ZSP-Electronics/ZSPR_01_Robot/README.md

# ZSPR_01_Robot
Repo containing all files to create the ZSPR-01 Robot
