ZSP-Electronics/ZSPR_01_Robot/hardware/KiCAD/Internal Battery Monitor/README.md

# Internal Battery Monitor

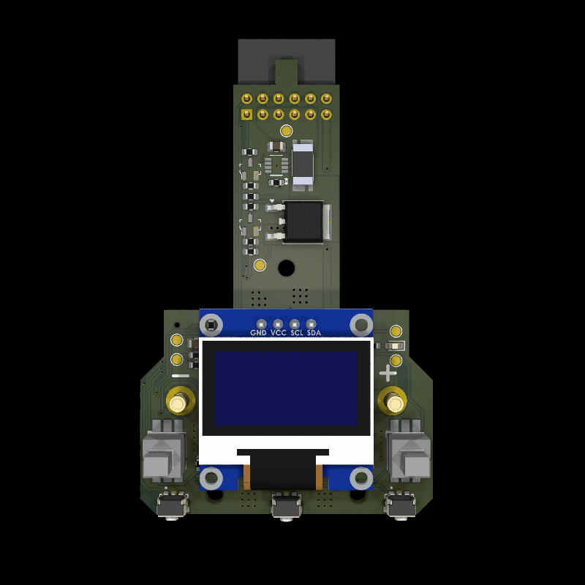
[picture p1: hardware/KiCAD/Internal Battery Monitor/renders/Internal Battery Monitor.gif]
Internal Battery Monitor render
