ZSP-Electronics/ZSPR_01_Robot/hardware/KiCAD/Primary Robot Controller/README.md

# Primary Robot Controller

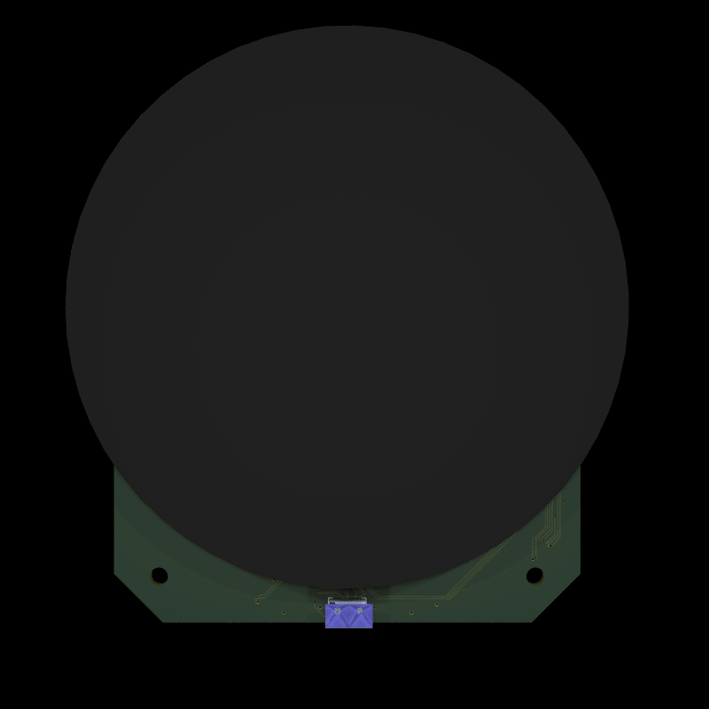
[picture p2: hardware/KiCAD/Primary Robot Controller/renders/Primary Robot Controller.gif]
Primary Robot Controller render
