ZSP-Electronics/ZSPR_01_Robot/hardware/KiCAD/Charge Board/production/bom.csv

Designator | Footprint | Quantity | Value | LCSC Part #
C1, C2 | 0805 | 2 | 10uF
C3 | 0603 | 1 | 100nF
J1 | JST_PH_B2B-PH-K_1x02_P2.00mm_Vertical | 1 | Conn_01x02_Pin
J2 | Magnetic_Pogo_Pins | 1 | Conn_01x04_Socket
J3 | JST_PH_B3B-PH-K_1x03_P2.00mm_Vertical | 1 | Conn_01x03_Pin
Q2 | SOT-363_SC-70-6 | 1 | 2N7002DW-7-F | 2N7002DW-7-F
R10, R8 | 0603 | 2 | 10k
R5, R6, R7, R9 | 0402 | 4 | 10K
U1 | SOT-23 | 1 | AP2127N-2.8
U2 | VL53L0CXV0DH_1 | 1 | VL53L0CXV0DH_1 | VL53L0CXV0DH/1
