ZSP-Electronics/ZSPR_01_Robot/hardware/KiCAD/Primary Robot Controller/production/bom.csv

Designator | Footprint | Quantity | Value | LCSC Part #
BZ1 | MagneticBuzzer_Kobitone_254-EMB84Q-RO | 1 | Buzzer
C1, C17, C2, C3, C36, C4, C70, C71, C74, C75 | 0603 | 10 | 1uF
C10, C11, C14, C19, C20, C23, C24, C34, C5, C6, C7 | 0805 | 11 | 10uF
C12, C15, C16, C18, C25, C26, C27, C35, C37, C45, C47 | 0603 | 11 | 100nF
C13 | CP_EIA-7343-31_Kemet-D | 1 | 100uF
C21, C22, C43, C44 | 0805 | 4 | 22uF
C65 | 0603 | 1 | 4.7uF
C8 | CP_Elec_6.3x5.8 | 1 | 220uF
C9 | CP_Elec_6.3x5.8 | 1 | 100uF
D1, D2 | 0603 | 2 | RED
J1 | IDC-Header_2x06_P2.54mm_Vertical | 1 | Conn_02x06_Odd_Even
J10 | microSD_External_Pin | 1 | microSD
J2 | 2_8in_lcd_40pin05pitch | 1 | Conn_01x40_Pin
J3 | Molex_SPOX_5267-03A_1x03_P2.50mm_Vertical | 1 | Conn_01x03_Socket
J4 | TE_1-84952-5_1x15-1MP_P1.0mm_Horizontal | 1 | Conn_01x15_Socket
J6 | JST_PH_B2B-PH-K_1x02_P2.00mm_Vertical | 1 | Conn_01x02_Socket
J7 | PinSocket_2x04_P2.54mm_Vertical | 1 | Conn_02x04_Counter_Clockwise
L2 | L_Chilisin_BMRF00101040 | 1 | 3.3uH
L3 | L_APV_APH0530 | 1 | 2.2uH
Q1, Q5 | SOT-23 | 2 | DMN10H220L
Q2, Q3 | TO-252-2 | 2 | SUD50P08-25L
Q4 | SOT-23-3 | 1 | MMBT2907A-7-F | MMBT2907A-7-F
R1, R10, R14, R15, R16, R17, R18, R2, R20, R22, R23, R27, R28, R29, R4, R45, R54, R55, R7 | 0603 | 19 | 10K
R11, R5 | R_Shunt_Vishay_WSK2512_6332Metric_T1.19mm | 2 | 5mOhm
R12 | 0603 | 1 | 270K
R13, R46 | 0603 | 2 | 36.5K
R19, R31, R32, R38, R39, R40, R41, R42, R43, R48, R51, R56, R57 | 0603 | 13 | 47K
R21, R8 | 0603 | 2 | 1K
R24, R25, R26, R30, R33, R34, R35, R36, R52, R53 | 0603 | 10 | 4.7K
R3, R9 | 0603 | 2 | 2.2K
R37 | 0603 | 1 | 167K
R44 | 0603 | 1 | 300
R47, R49, R50, R58, R59 | 0603 | 5 | 100K
R6 | 1206 | 1 | 60
R60, R61 | 0603 | 2 | 330
RN1, RN2 | R_Array_Convex_4x0603 | 2 | 10K
TP1, TP2, TP3, TP4, TP5, TP6 | TestPoint_Pad_D1.5mm | 6 | TestPoint
U1, U2 | SOT_32AIDDFR_TEX | 2 | INA232AIDDFR
U10 | CONN_10018784_AMP | 1 | ~
U11 | XDCR_BMI270 | 1 | BMI270
U12 | WLP-4_0.86x0.86mm_P0.4mm | 1 | MMC5603NJ
U13, U8 | QFN50P400X400X80-25N | 2 | KTS1622EUAA-TR
U16 | SOT-23-5 | 1 | AP2112K-1.8
U17 | BMP180 | 1 | BMP180
U18 | IC17_LGA16_STM | 1 | VL53L8CXV0GC/1
U20, U21 | SOT5X3-6_DRL_TEX | 2 | TPS565247DRLR
U3 | SOT-753 | 1 | SN74LVC1G126DBVR | SN74LVC1G125DBVR
U4 | SOT-753 | 1 | SN74LVC1G125DBVR | SN74LVC1G125DBVR
U5, U6 | SOIC_3V204LEX_DIO | 2 | PI4ULS3V204LEX
U7 | SOIC-14_3.9x8.7mm_P1.27mm | 1 | AT42QT1070-S
U9 | ESP32-S3-WROOM-1U | 1 | ESP32-S3-WROOM-1U-N4
