ZSP-Electronics/ZSPR_01_Robot/hardware/KiCAD/Servo Bus Connector/production/bom.csv

Designator | Footprint | Quantity | Value | LCSC Part #
J1, J10, J2, J3, J4, J5, J6, J7, J8, J9 | Molex_SPOX_5268-03A_1x03_P2.50mm_Horizontal | 10 | Conn_01x03_Socket
J11, J12 | Molex_SPOX_5267-03A_1x03_P2.50mm_Vertical | 2 | Conn_01x03_Socket
