ZSP-Electronics/ZSPR_01_Robot/hardware/STL Models/back_assembly.stl

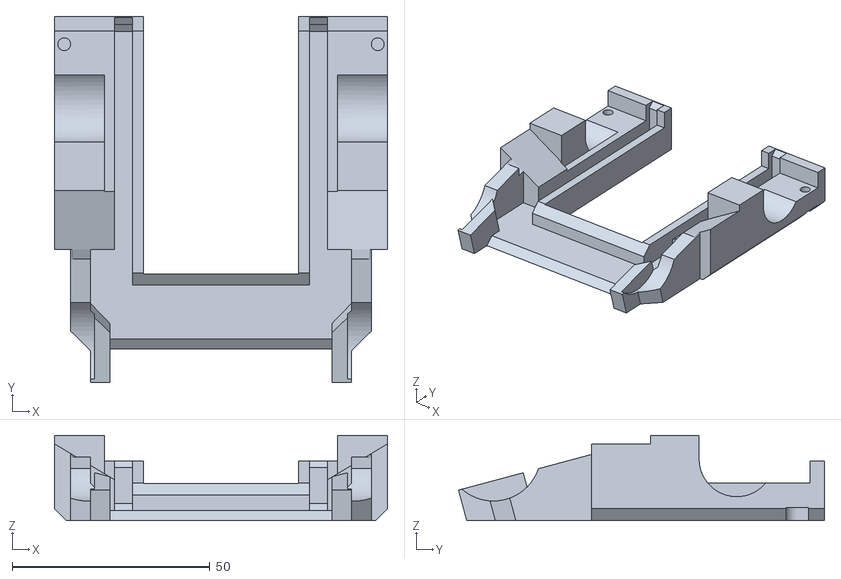
[picture p3: CAD file, 2026-09-27]
hardware/STL Models/back_assembly.stl
84.2 x 92.5 x 21.5
