ZSP-Electronics/ZSPR_01_Robot/hardware/KiCAD/Charge Board/Charge Board.step

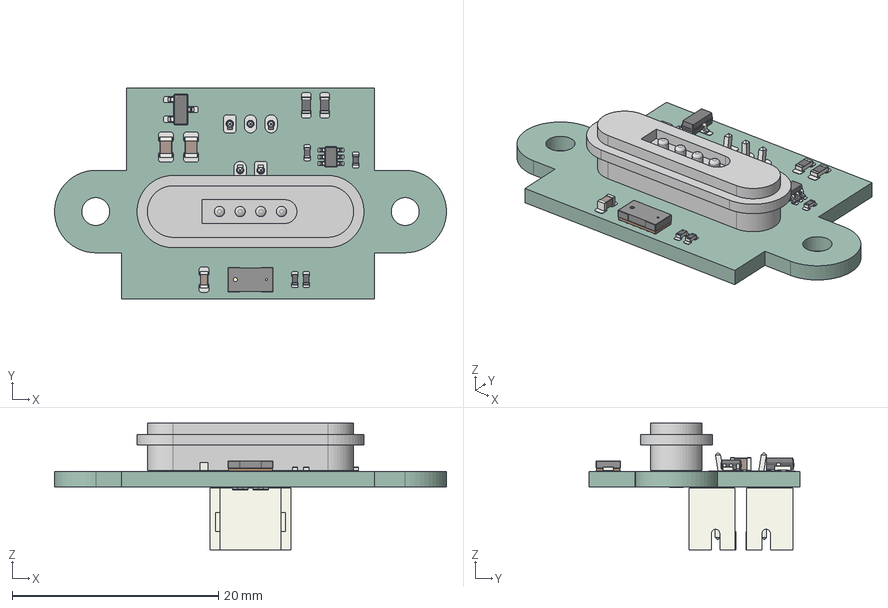
[picture p4: CAD file, 2026-09-27]
hardware/KiCAD/Charge Board/Charge Board.step
38.0 x 20.5 x 12.3 mm
SOT-23
C_0805_2012Metric x 2
R_0402_1005Metric x 4
Magnetic Pogo Male
C_0603_1608Metric
R_0603_1608Metric x 2
SOT-363_SC-70-6
VL53L0CXV0DH_1
JST_PH_B3B-PH-K_1x03_P2.00mm_Vertical
JST_PH_B2B-PH-K_1x02_P2.00mm_Vertical
Charge Board_pad
Charge Board_PCB
