ZSP-Electronics/ZSPR_01_Robot/hardware/KiCAD/Internal Battery Monitor/Internal Battery Monitor.step

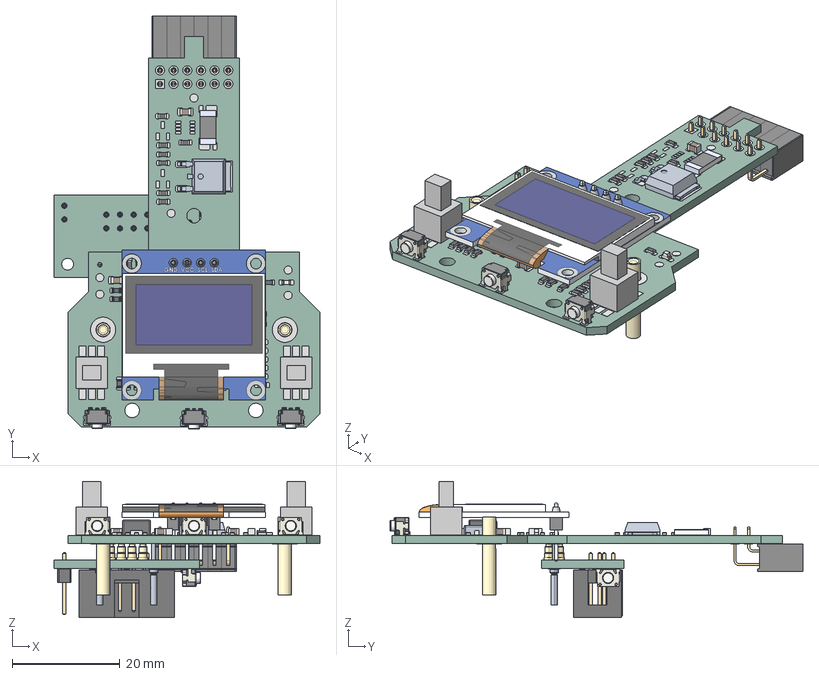
[picture p5: CAD file, 2026-09-27]
hardware/KiCAD/Internal Battery Monitor/Internal Battery Monitor.step
49.4 x 76.8 x 25.4 mm
R_0603_1608Metric x 26
C_0603_1608Metric x 2
C_0805_2012Metric x 13
TL3340AF160QG x 4
Push_Lock_button x 2
LED_0603_1608Metric
CSSU2512FT5L00
OLED-128x64-0.96
Internal Battery MonitorV2 1.28.1
Internal Battery MonitorV2 1.41.1
L_APV_APH0530
PinHeader_1x02_P2.54mm_Vertical
IDC-Header_2x04_P2.54mm_Vertical
c-38941-22l-1-3d x 2
SWD_Programmer_V2_PCB
Pin_PCB-Female x 2
PPPC022LJBN-RC_C06
Pin - Gold x 6
Internal Battery Monitor_pad
Internal Battery Monitor_PCB
