ZSP-Electronics/ZSPR_01_Robot/hardware/KiCAD/Primary Robot Controller/Primary Robot Controller.step

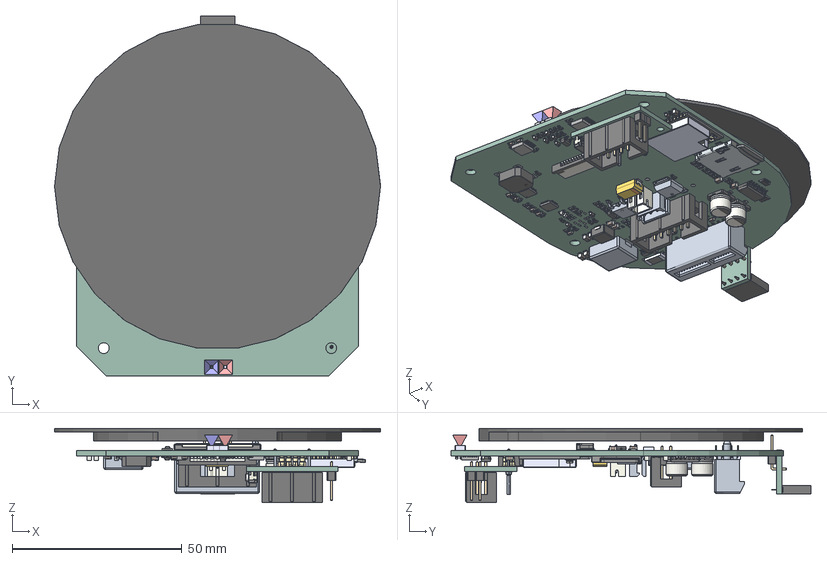
[picture p6: CAD file, 2026-09-27]
hardware/KiCAD/Primary Robot Controller/Primary Robot Controller.step
96.0 x 106.0 x 21.9 mm
R_0603_1608Metric x 58
VL53L8 SUBSTRATE
VL53L8 CAP
VL53L8 Rx Exclusion Cone
VL53L8 Tx Exclusion Cone
C_0603_1608Metric x 22
C_0805_2012Metric x 15
SOT-23 x 2
CSSU2512FT5L00 x 2
R_1206_3216Metric
62684 additional-21 body_40
pin^62684 additional-21 ASS x 40
LCD
BODY-SO x 2
LEAD-SO x 16
PIN1-ID x 2
KTS1622EUAA-TR x 2
R_Array_Convex_4x0603 x 2
ESP32-S3-WROOM-1U-N4
10018784-10200TLF
SOT-23-5
LED_0603_1608Metric x 2
PI4ULS3V204LEX x 2
L_APV_APH0530
Primary Robot Controller 1.66.1
BMI270
Primary Robot Controller 1.75.1 x 2
IDC-Header_2x06_P2.54mm_Vertical
SOIC-14_3.9x8.7mm_P1.27mm
JST_PH_B2B-PH-K_1x02_P2.00mm_Vertical
CP_EIA-7343-31_Kemet-D
MagneticBuzzer_Kobitone_254-EMB84Q-RO
PinHeader_1x02_P2.54mm_Vertical
IDC-Header_2x04_P2.54mm_Vertical
c-38941-22l-1-3d x 2
TL3340AF160QG
SWD_Programmer_V2_PCB
CSD03S010R x 14
microSD_Card
TE_1-84952-5_1x15-1MP_P1.0mm_Horizontal
WLP-4_0.86x0.86mm_P0.4mm
CP_Elec_6.3x5.8 x 2
PinSocket_1x04_P2.54mm_Vertical
PinHeader_1x04_P2.54mm_Horizontal
Capacitive Adapter Board_PCB
Primary Robot Controller_pad
Primary Robot Controller_PCB
