ZSP-Electronics/ZSPR_01_Robot/hardware/KiCAD/Servo Bus Connector/Servo_Bus.step

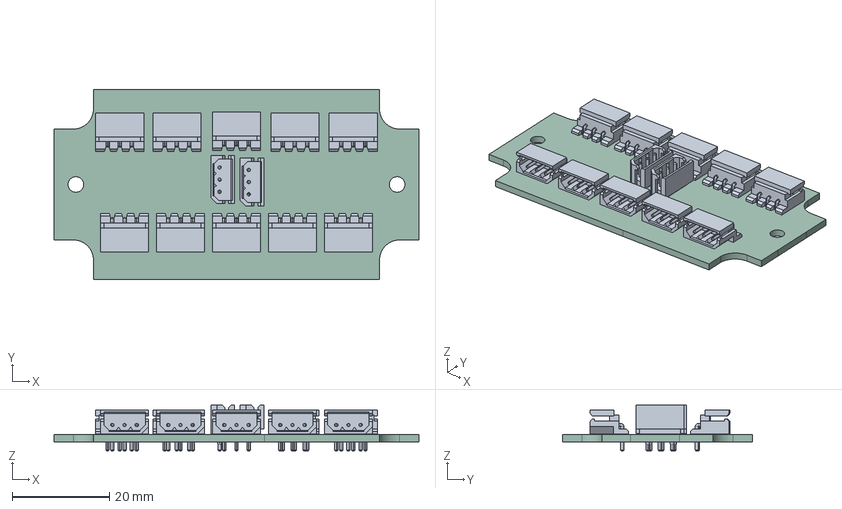
[picture p7: CAD file, 2026-09-27]
hardware/KiCAD/Servo Bus Connector/Servo_Bus.step
75.0 x 39.0 x 9.40 mm
Servo_Bus_PCB
