ZSP-Electronics/ZSPR_01_Robot/hardware/STL Models/arm_house_front1.stl

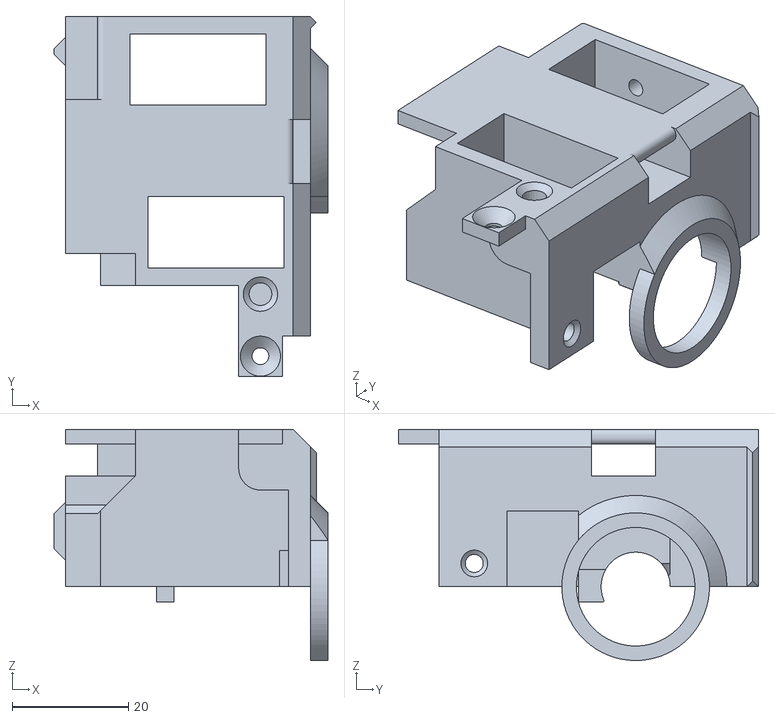
[picture p8: CAD file, 2026-09-27]
hardware/STL Models/arm_house_front1.stl
47.1 x 61.9 x 39.7
