ZSP-Electronics/ZSPR_01_Robot/hardware/STL Models/arm_house_front2.stl

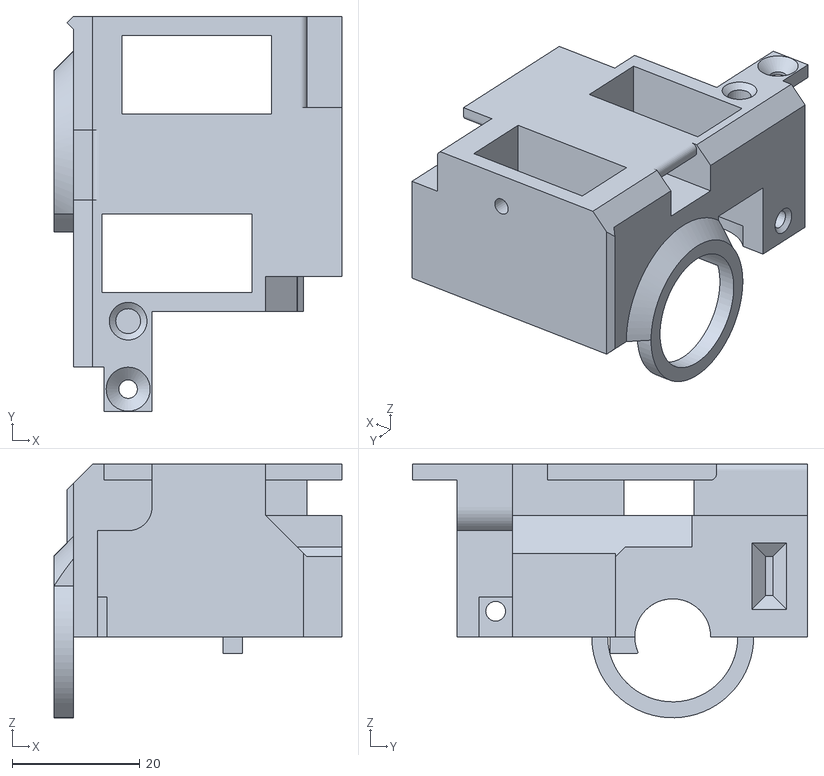
[picture p9: CAD file, 2026-09-27]
hardware/STL Models/arm_house_front2.stl
45.1 x 61.9 x 39.7
