ZSP-Electronics/ZSPR_01_Robot/hardware/STL Models/servo_gear_6x.stl

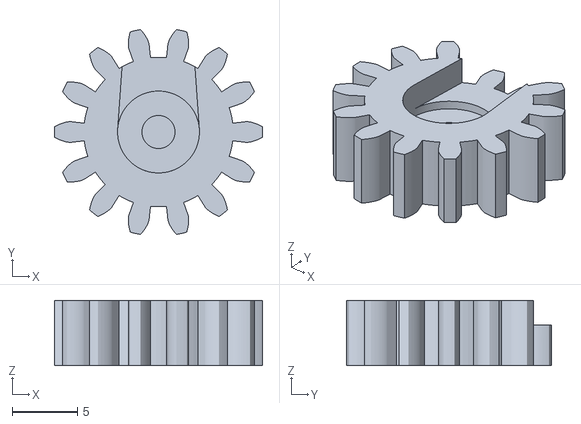
[picture p10: CAD file, 2026-09-27]
hardware/STL Models/servo_gear_6x.stl
16.0 x 15.8 x 5.00
