ZSP-Electronics/ZSPR_01_Robot/hardware/STL Models/arm_arm_body2_mirror.stl

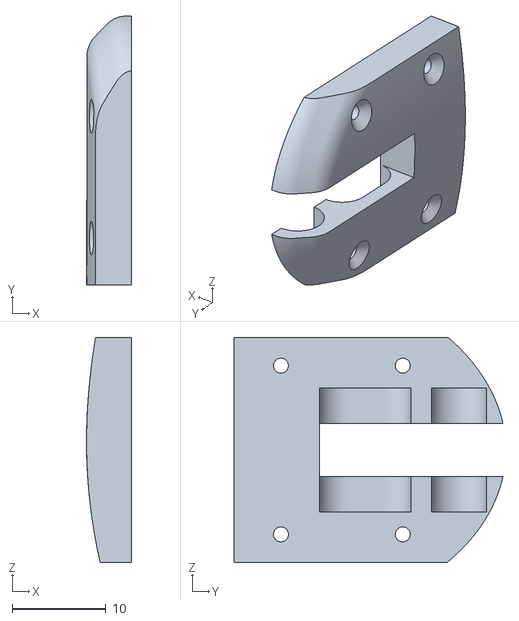
[picture p11: CAD file, 2026-09-27]
hardware/STL Models/arm_arm_body2_mirror.stl
4.80 x 28.7 x 24.0
