ZSP-Electronics/ZSPR_01_Robot/hardware/STL Models/ear_housing1_mirror.stl

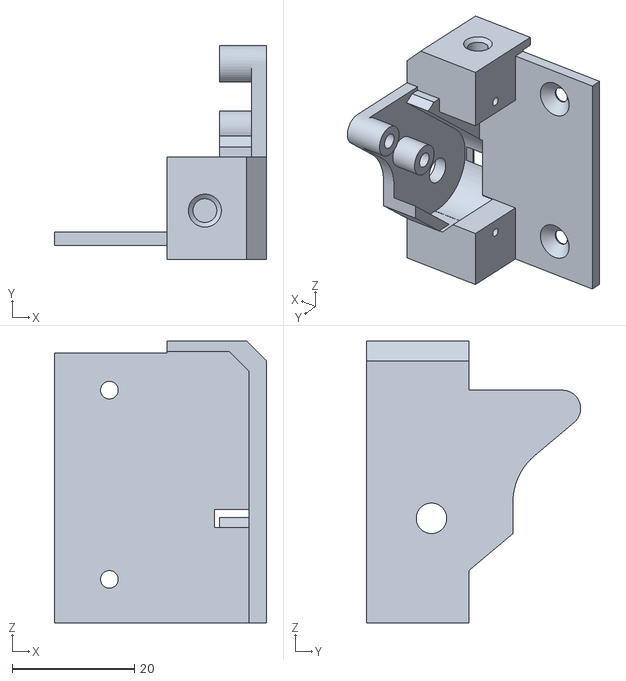
[picture p12: CAD file, 2026-09-27]
hardware/STL Models/ear_housing1_mirror.stl
34.7 x 35.1 x 46.2
