ZSP-Electronics/ZSPR_01_Robot/hardware/STL Models/bottom_riser_2x.stl

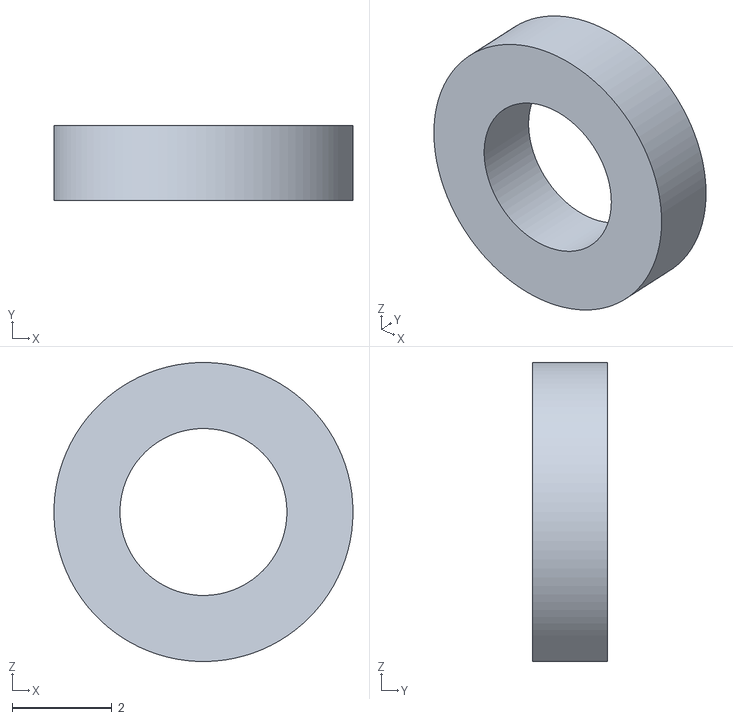
[picture p13: CAD file, 2026-09-27]
hardware/STL Models/bottom_riser_2x.stl
6.00 x 1.50 x 6.00
