ZSP-Electronics/ZSPR_01_Robot/hardware/STL Models/screen_mount.stl

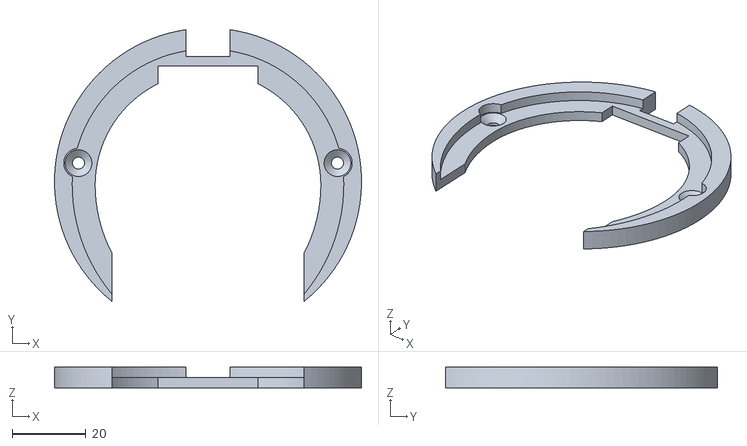
[picture p14: CAD file, 2026-09-27]
hardware/STL Models/screen_mount.stl
83.0 x 73.4 x 5.58
