ZSP-Electronics/ZSPR_01_Robot/hardware/STL Models/arm_servo_gear2_2x.stl

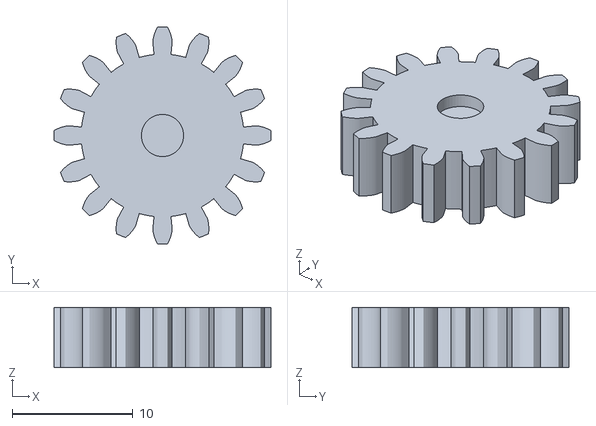
[picture p15: CAD file, 2026-09-27]
hardware/STL Models/arm_servo_gear2_2x.stl
18.0 x 18.0 x 5.00
