ZSP-Electronics/ZSPR_01_Robot/hardware/STL Models/arm_house_back.stl

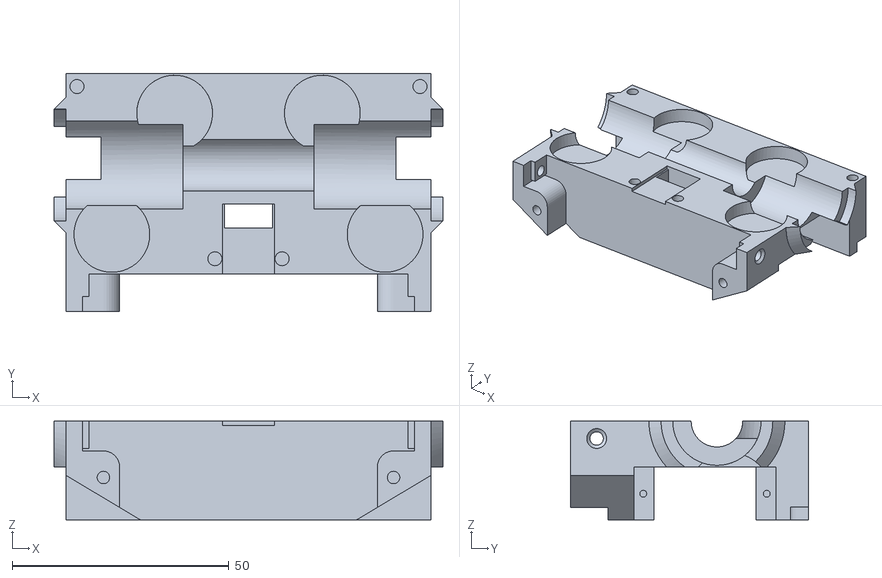
[picture p16: CAD file, 2026-09-27]
hardware/STL Models/arm_house_back.stl
89.8 x 54.9 x 22.8
