ZSP-Electronics/ZSPR_01_Robot/hardware/STL Models/arm_housing_tensioner_mirror.stl

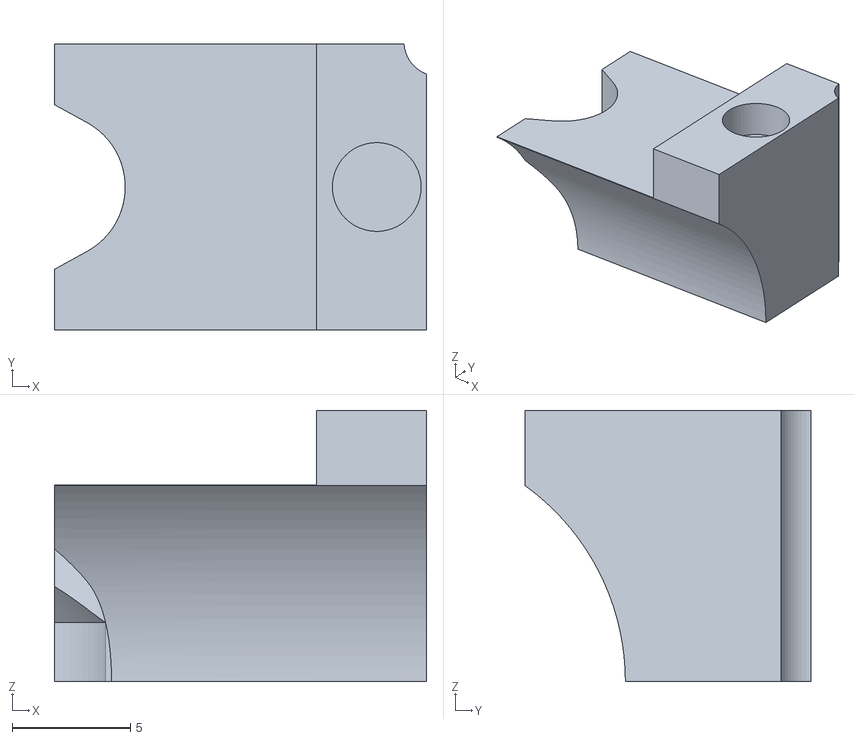
[picture p17: CAD file, 2026-09-27]
hardware/STL Models/arm_housing_tensioner_mirror.stl
15.7 x 12.1 x 11.4
