ZSP-Electronics/ZSPR_01_Robot/hardware/STL Models/arm_arm_body1_mirror.stl

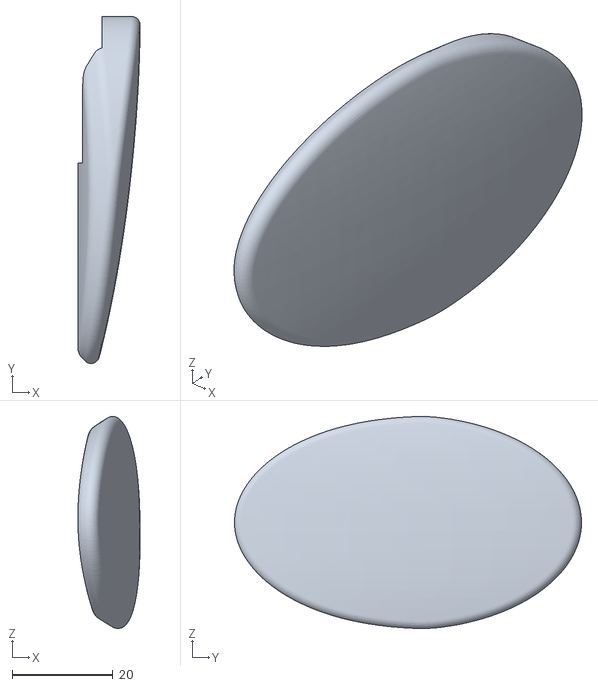
[picture p18: CAD file, 2026-09-27]
hardware/STL Models/arm_arm_body1_mirror.stl
12.4 x 68.9 x 42.1
