ZSP-Electronics/ZSPR_01_Robot/hardware/STL Models/foot_primary_gear.stl

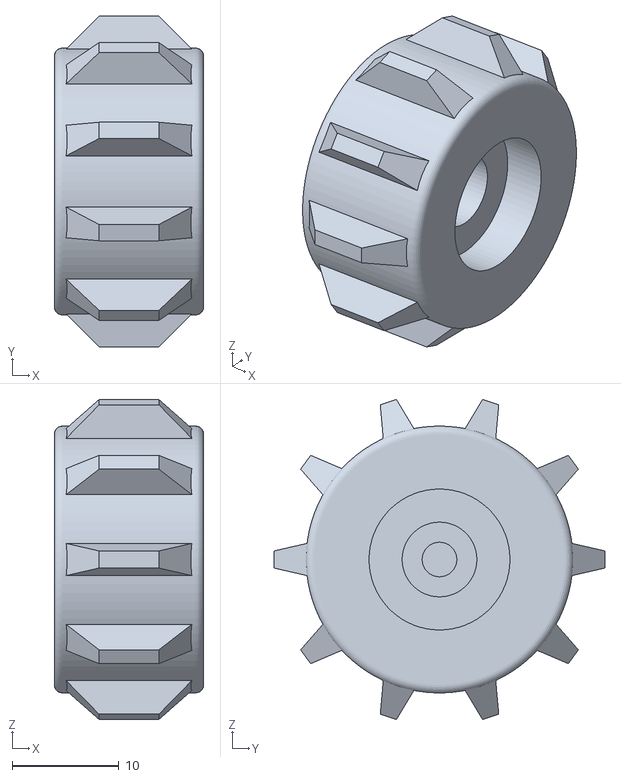
[picture p19: CAD file, 2026-09-27]
hardware/STL Models/foot_primary_gear.stl
14.0 x 31.0 x 30.0
