ZSP-Electronics/ZSPR_01_Robot/hardware/STL Models/ear_gear_2x.stl

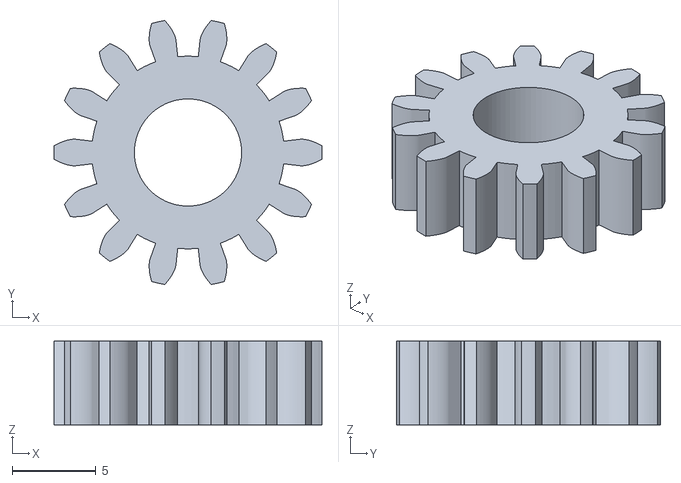
[picture p20: CAD file, 2026-09-27]
hardware/STL Models/ear_gear_2x.stl
16.0 x 15.8 x 5.00
