ZSP-Electronics/ZSPR_01_Robot/hardware/STL Models/bottom_outer_cover.stl

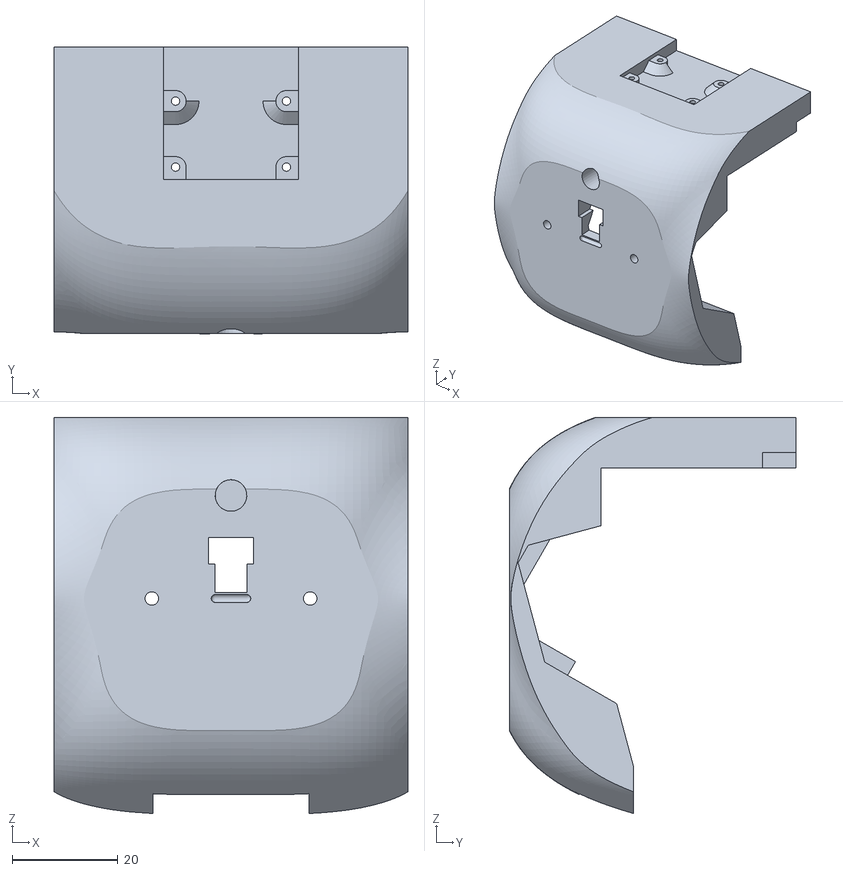
[picture p21: CAD file, 2026-09-27]
hardware/STL Models/bottom_outer_cover.stl
67.0 x 54.3 x 75.0
