ZSP-Electronics/ZSPR_01_Robot/hardware/STL Models/arm_link_rotor_gear_mirror.stl

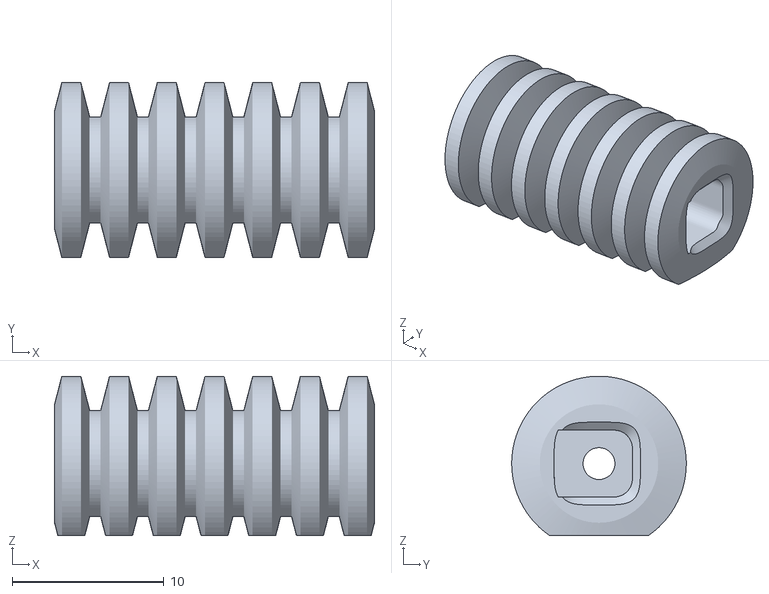
[picture p23: CAD file, 2026-09-27]
hardware/STL Models/arm_link_rotor_gear_mirror.stl
21.1 x 11.5 x 10.5
