ZSP-Electronics/ZSPR_01_Robot/hardware/STL Models/ear_housing2_mirror.stl

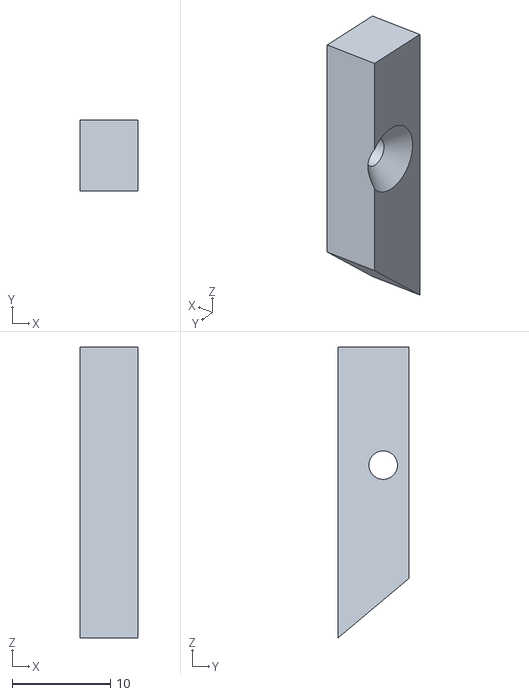
[picture p24: CAD file, 2026-09-27]
hardware/STL Models/ear_housing2_mirror.stl
5.90 x 7.22 x 29.6
