ZSP-Electronics/ZSPR_01_Robot/hardware/STL Models/foot_pivot_gear.stl

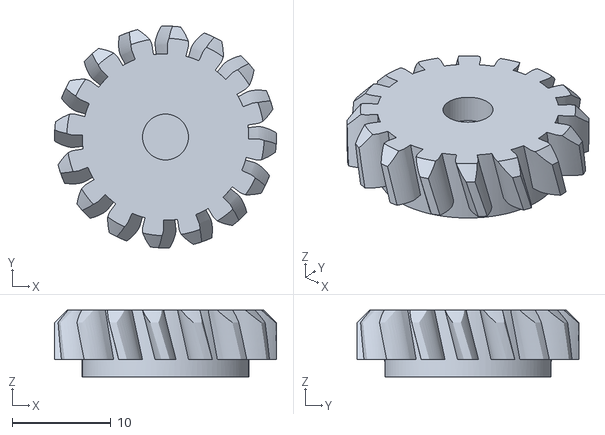
[picture p25: CAD file, 2026-09-27]
hardware/STL Models/foot_pivot_gear.stl
22.5 x 22.5 x 6.75
