ZSP-Electronics/ZSPR_01_Robot/hardware/STL Models/arm_link1_2x.stl

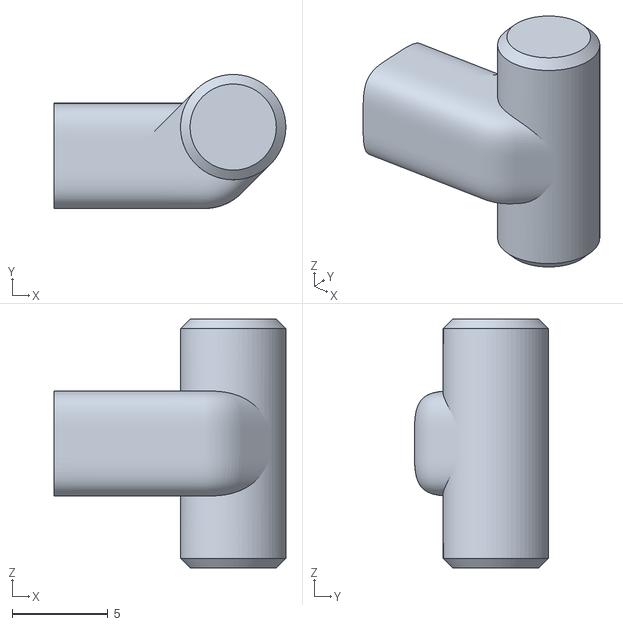
[picture p26: CAD file, 2026-09-27]
hardware/STL Models/arm_link1_2x.stl
12.1 x 7.00 x 13.0
