ZSP-Electronics/ZSPR_01_Robot/hardware/STL Models/arm_link2_2x.stl

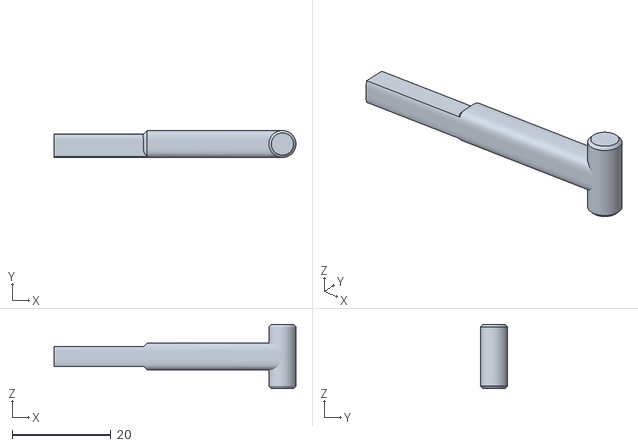
[picture p27: CAD file, 2026-09-27]
hardware/STL Models/arm_link2_2x.stl
49.1 x 5.50 x 13.0
