ZSP-Electronics/ZSPR_01_Robot/hardware/STL Models/bottom_motor_mount.stl

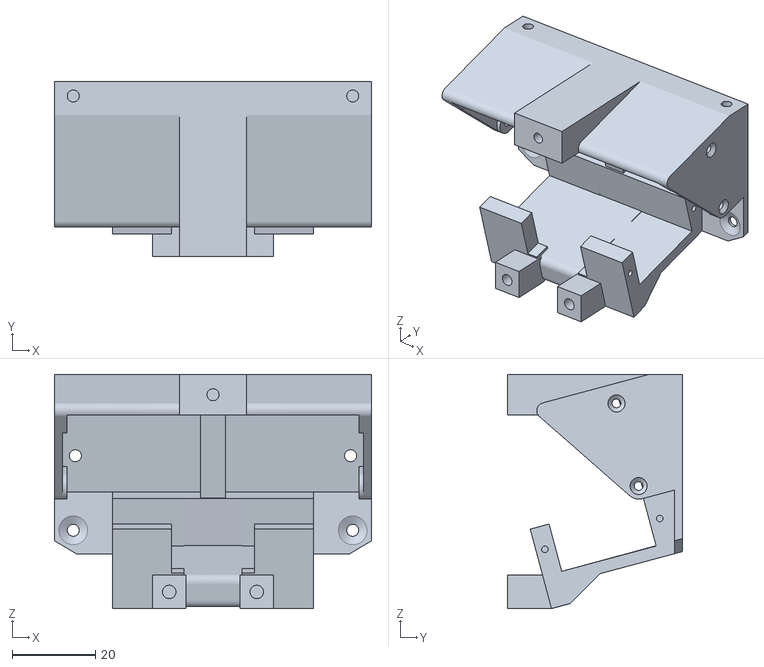
[picture p28: CAD file, 2026-09-27]
hardware/STL Models/bottom_motor_mount.stl
76.0 x 42.0 x 56.2
