ZSP-Electronics/ZSPR_01_Robot/hardware/STL Models/arm_link_gear_mirror.stl

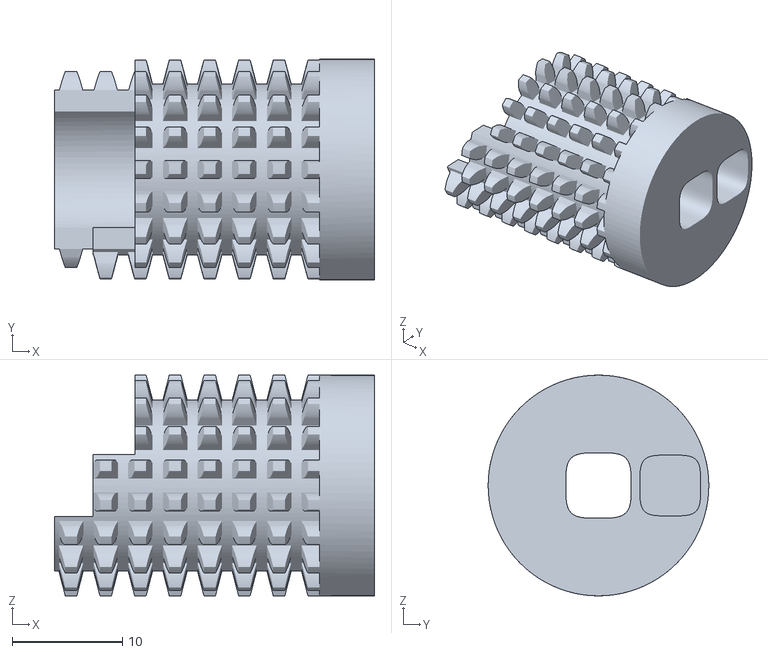
[picture p29: CAD file, 2026-09-27]
hardware/STL Models/arm_link_gear_mirror.stl
29.0 x 20.0 x 20.0
