ZSP-Electronics/ZSPR_01_Robot/hardware/STL Models/foot_panel1_2x.stl

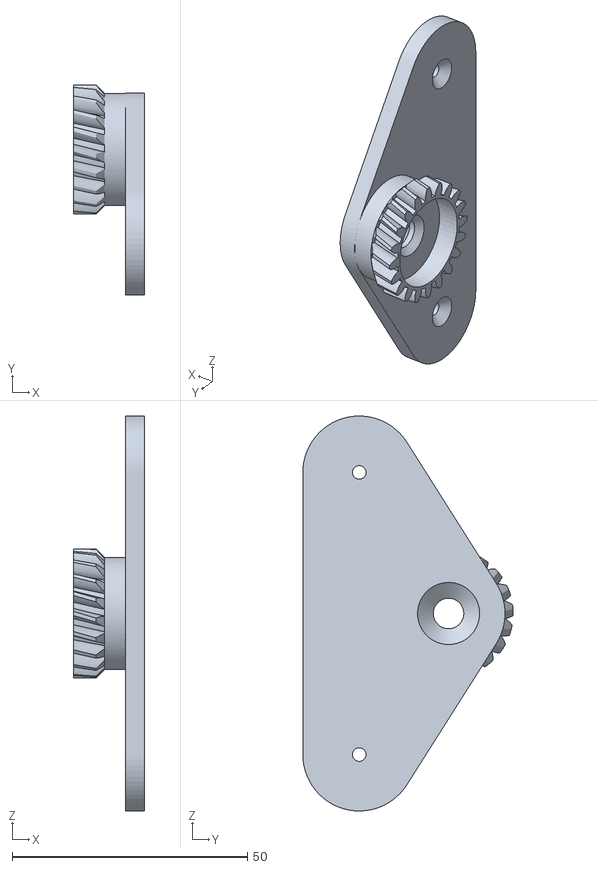
[picture p30: CAD file, 2026-09-27]
hardware/STL Models/foot_panel1_2x.stl
15.1 x 44.7 x 84.0
