ZSP-Electronics/ZSPR_01_Robot/hardware/STL Models/foot_panel2_2x.stl

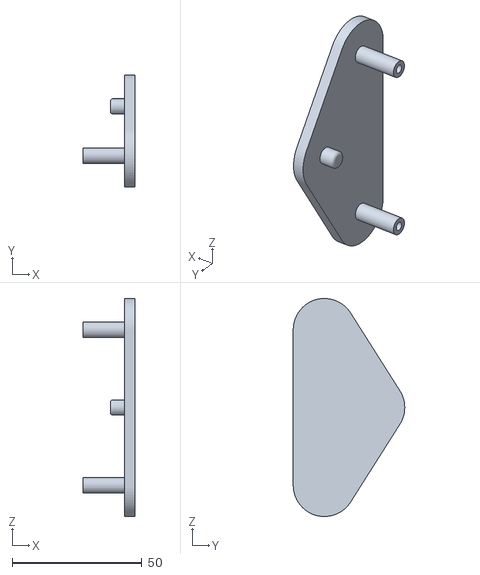
[picture p31: CAD file, 2026-09-27]
hardware/STL Models/foot_panel2_2x.stl
20.0 x 43.0 x 84.0
