ZSP-Electronics/ZSPR_01_Robot/hardware/STL Models/screen_riser2_2x.stl

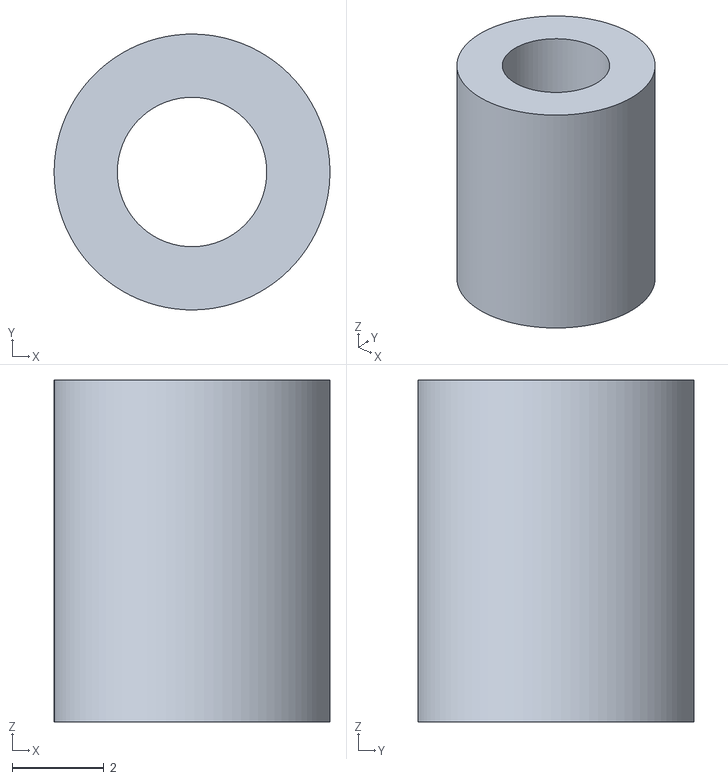
[picture p32: CAD file, 2026-09-27]
hardware/STL Models/screen_riser2_2x.stl
6.00 x 6.00 x 7.44
