ZSP-Electronics/ZSPR_01_Robot/hardware/STL Models/ZSPR_01_Print_Layout.3mf

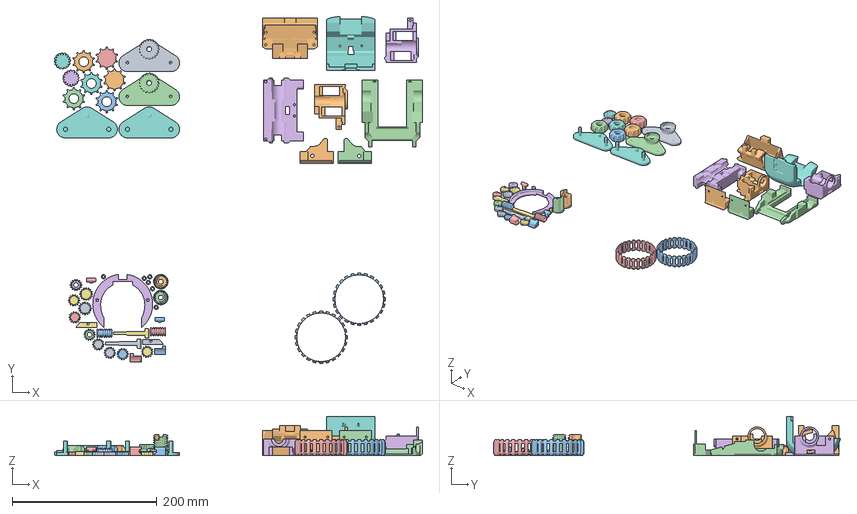
[picture p33: CAD file, 2026-09-27]
hardware/STL Models/ZSPR_01_Print_Layout.3mf
509.8 x 480.2 x 54.3 mm
foot_panel1_2x.stl x 2
arm_link_gear_mirror.stl x 2
track.stl x 2
screen_mount.stl
arm_link2_2x.stl x 2
bottom_outer_cover.stl
bottom_motor_mount.stl
arm_link1_2x.stl x 2
arm_house_front1.stl
arm_servo_gear2_2x.stl x 2
foot_panel2_2x.stl x 2
arm_house_front2.stl
arm_link_rotor_gear_mirror.stl x 2
back_assembly.stl
arm_house_back.stl
ear_housing2_mirror.stl x 2
foot_primary_gear.stl x 2
foot_secondary_gear_2x.stl x 4
ear_gear_2x.stl x 2
servo_gear_6x.stl x 6
foot_pivot_gear.stl x 2
ear_housing1_mirror.stl x 2
arm_housing_tensioner_mirror.stl x 2
screen_riser1_2x.stl x 2
bottom_riser_2x.stl x 2
screen_riser2_2x.stl x 2
