ZSP-Electronics/ZSPR_01_Robot/hardware/STL Models/ear_arm_mirror.stl

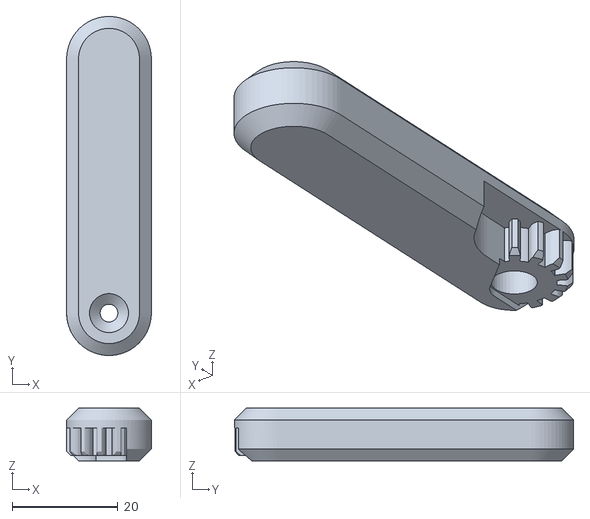
[picture p34: CAD file, 2026-09-27]
hardware/STL Models/ear_arm_mirror.stl
16.0 x 64.0 x 10.0
