ZSP-Electronics/ZSPR_01_Robot/hardware/STL Models/track_2x.stl

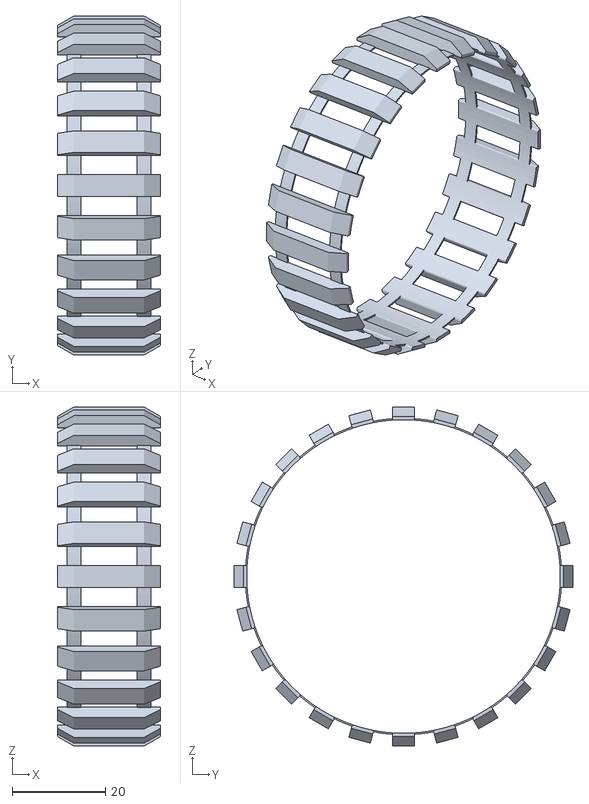
[picture p35: CAD file, 2026-09-27]
hardware/STL Models/track_2x.stl
22.0 x 72.6 x 72.6
