ZSP-Electronics/ZSPR_01_Robot/(list of files, cad)

Other CAD files:
hardware/STL Models/foot_secondary_gear_2x.stl
