ZSP-Electronics/ZSPR_01_Robot/hardware/KiCAD/Primary Robot Controller/Primary Robot Controller Schematic.pdf

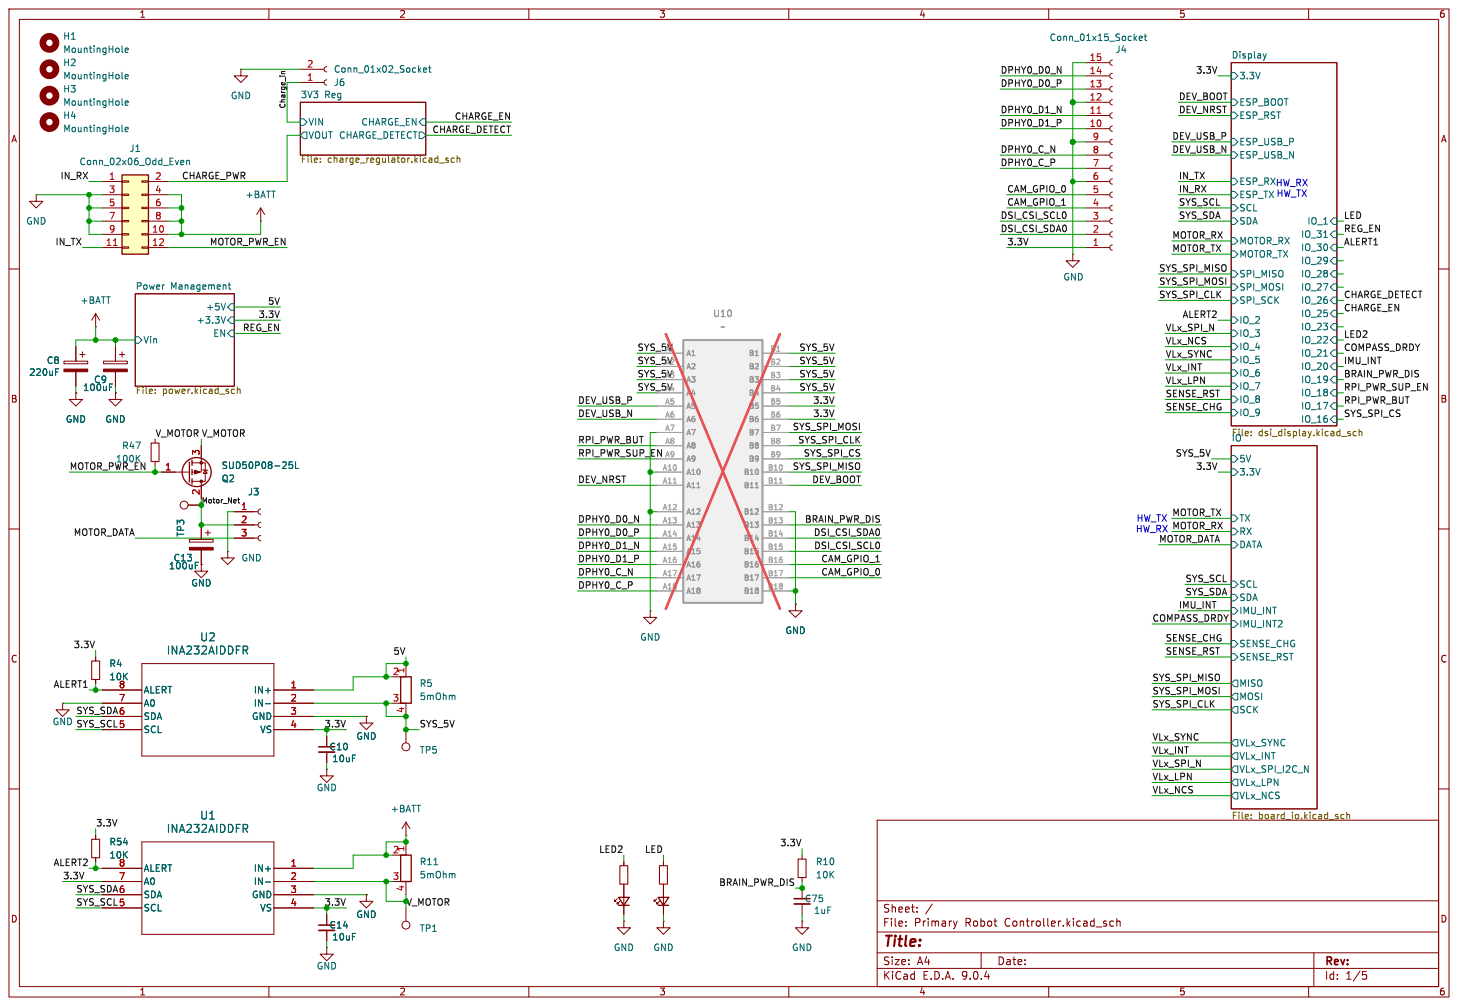
[picture p36: page 1]

H4 MountingHole H2 MountingHole H1 MountingHole H3 MountingHole GND

Power Management File: power.kicad_sch

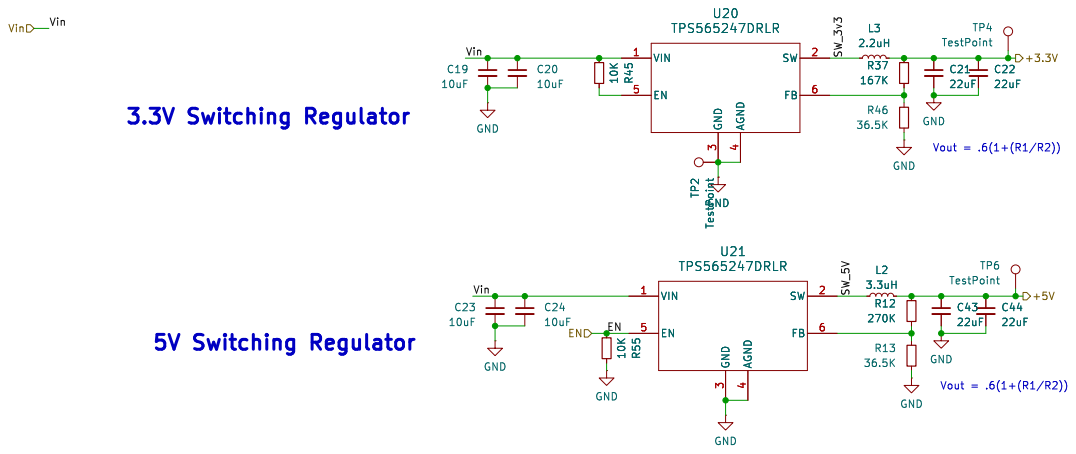
[picture p37: page 2]

4 SW 2 FB 6 10K R45 GND TP2 TestPoint U21 TPS565247DRLR

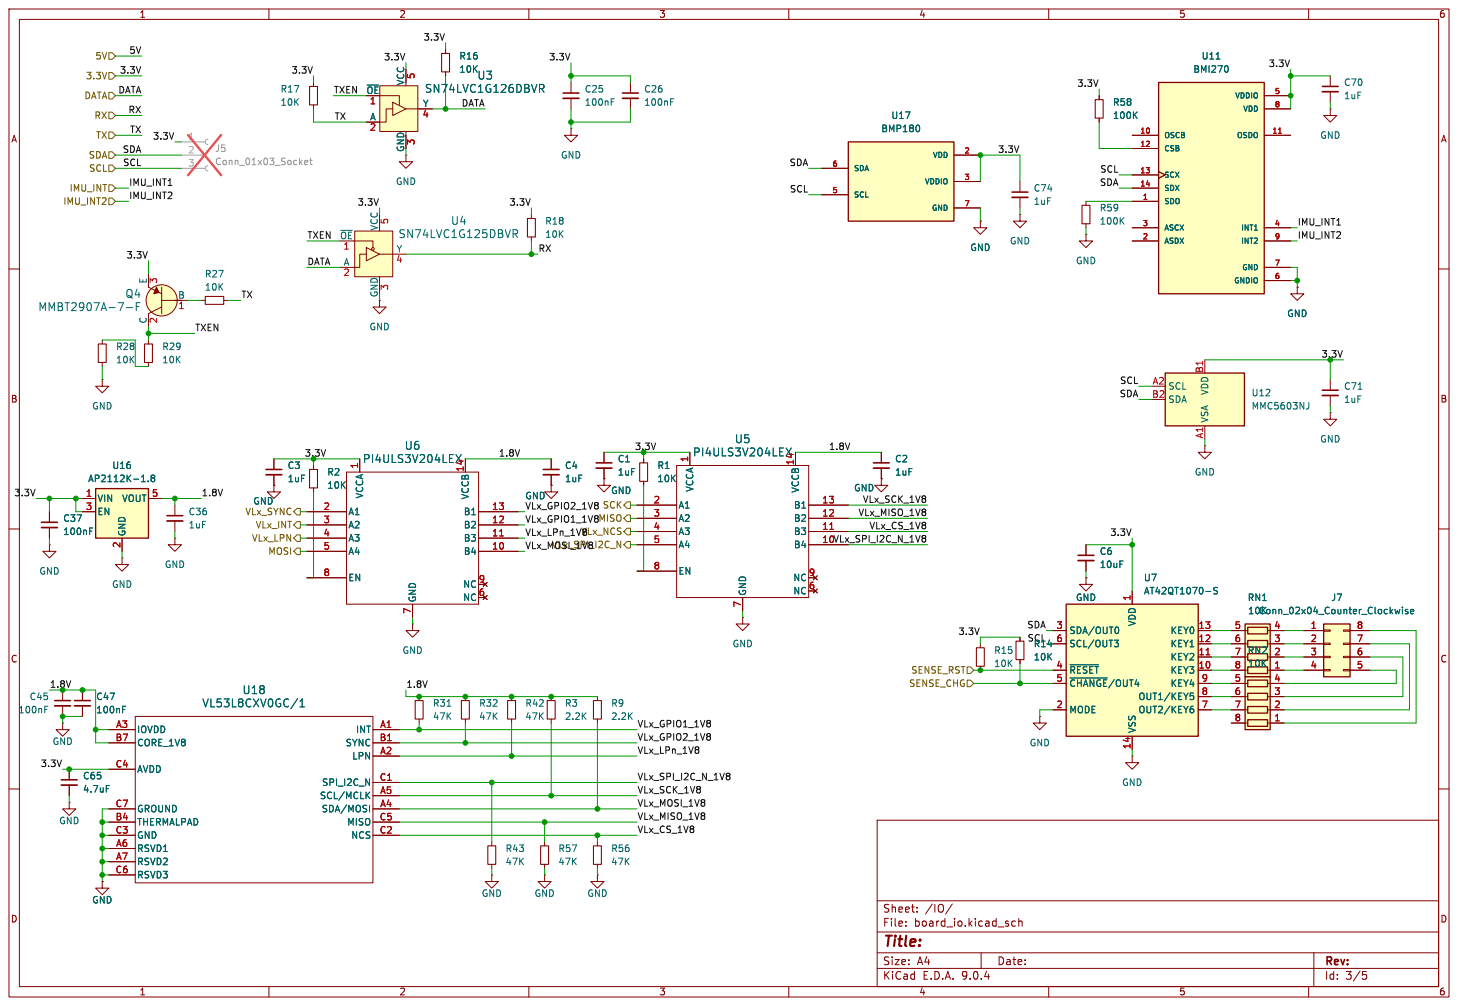
[picture p38: page 3]

7 VCCB 14 NC 9 NC 6 GND

Id: 3/5 Title: File: board_io.kicad_sch Sheet: /IO/

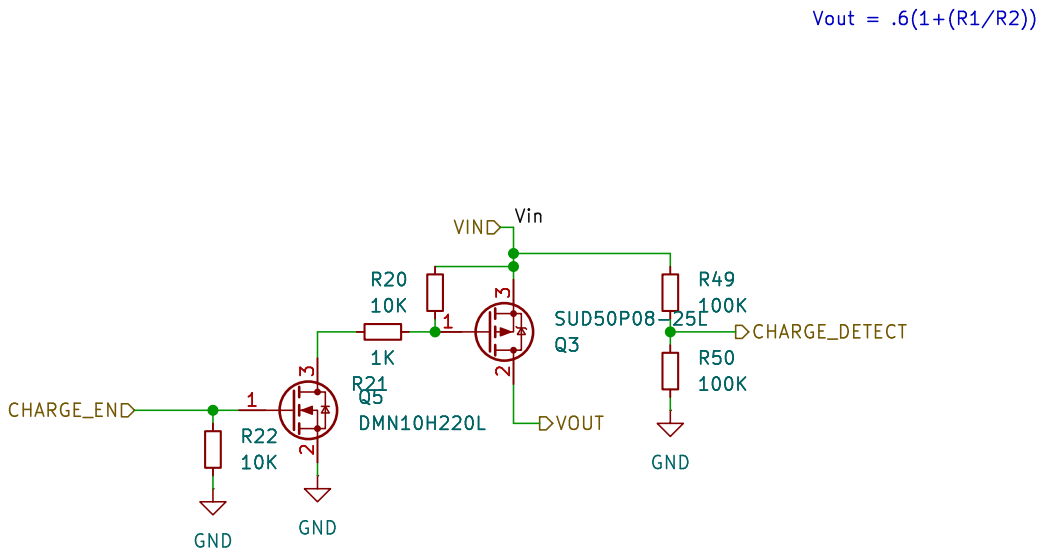
[picture p39: page 4]

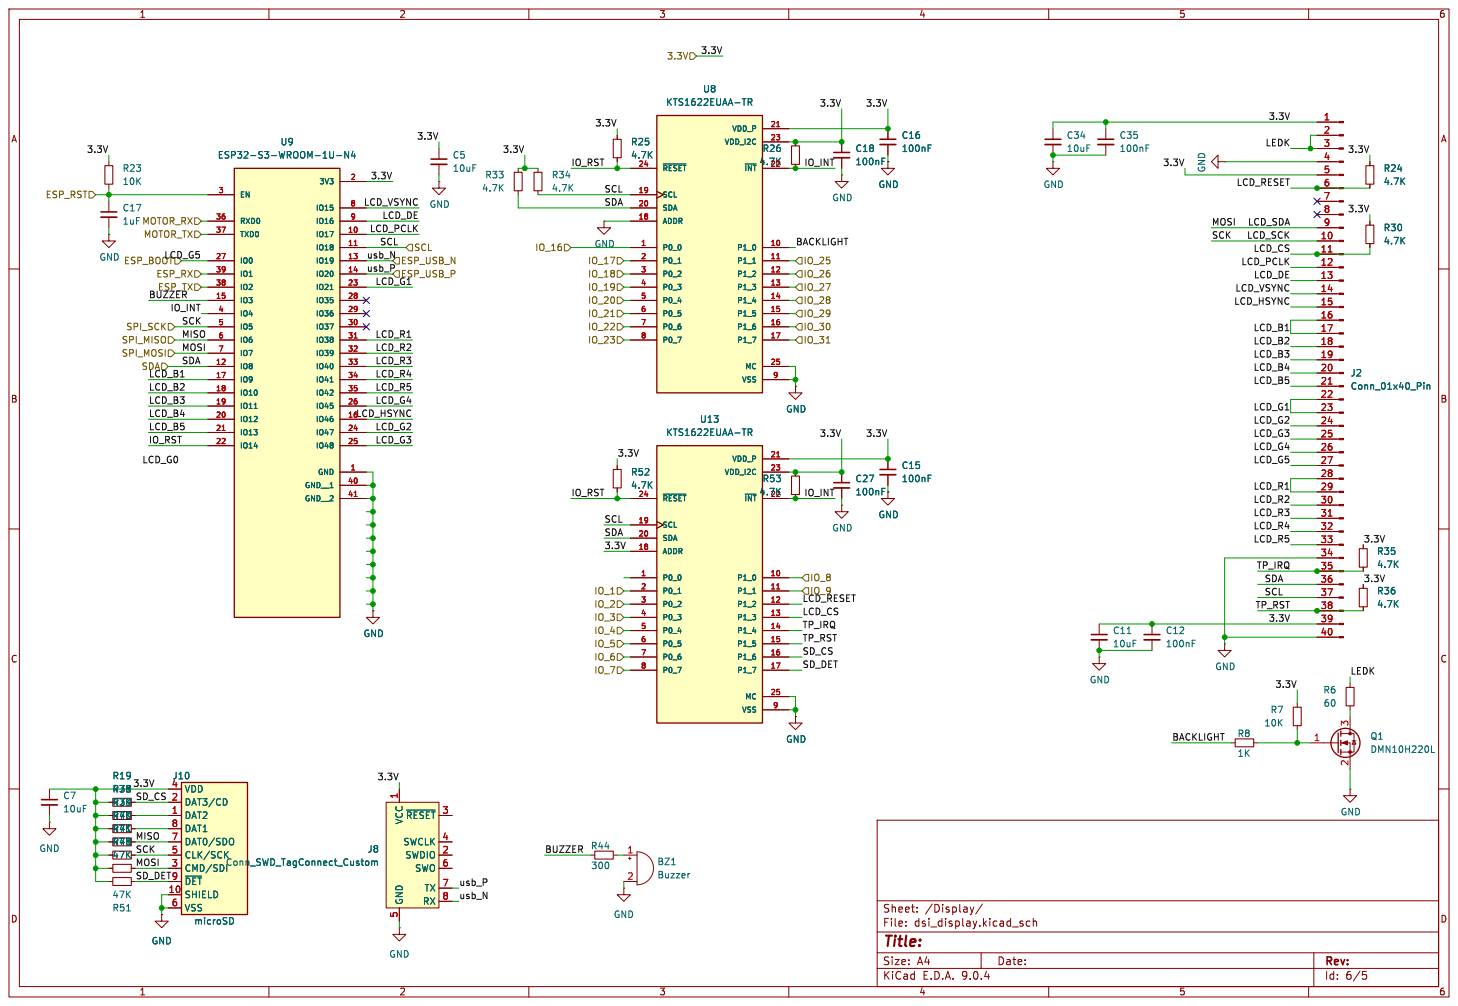
[picture p40: page 5]

5 ~{RESET}3 SWCLK 4 SWDIO 2 SWO 6 TX 7 RX 8

Id: 6/5 Title: File: dsi_display.kicad_sch Sheet: /Display/
