ZSP-Electronics/ZSPR_01_Robot/hardware/KiCAD/Charge Board/Charge Board.pdf

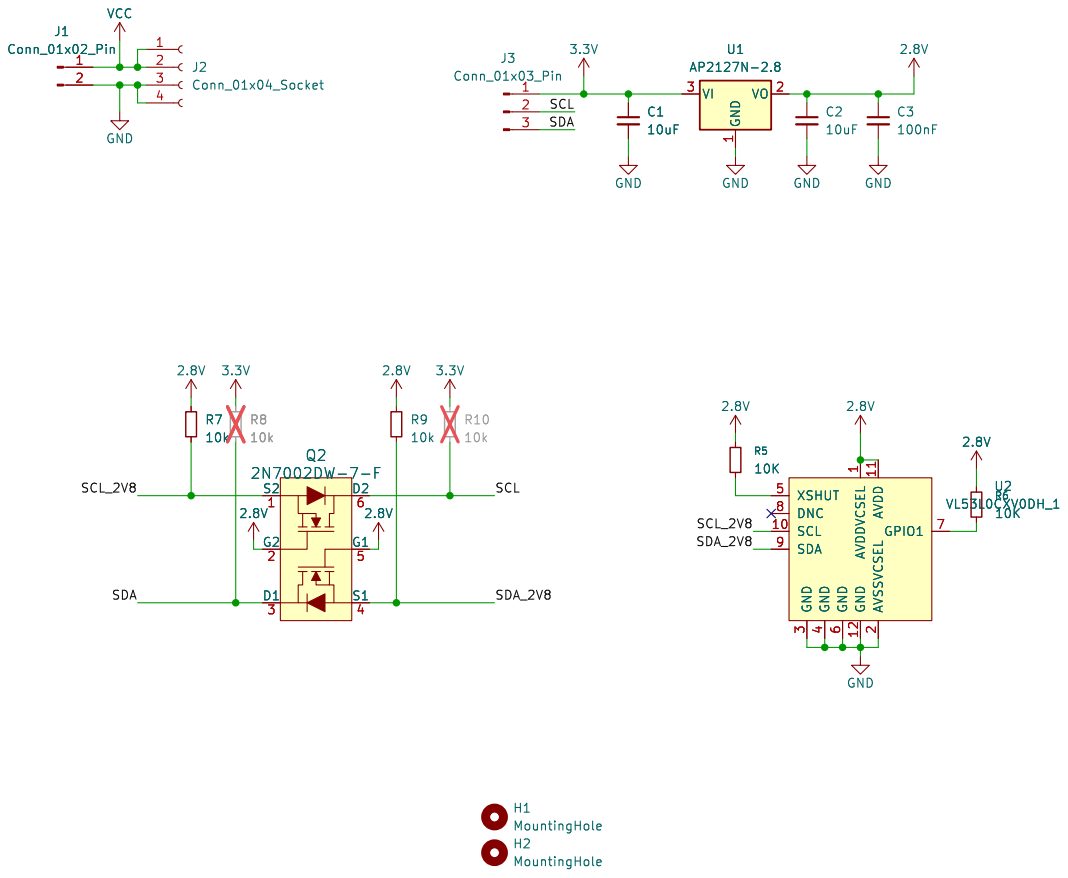
[picture p41: page 1]
