ZSP-Electronics/ZSPR_01_Robot/hardware/KiCAD/Internal Battery Monitor/Internal Battery Monitor Schematic.pdf

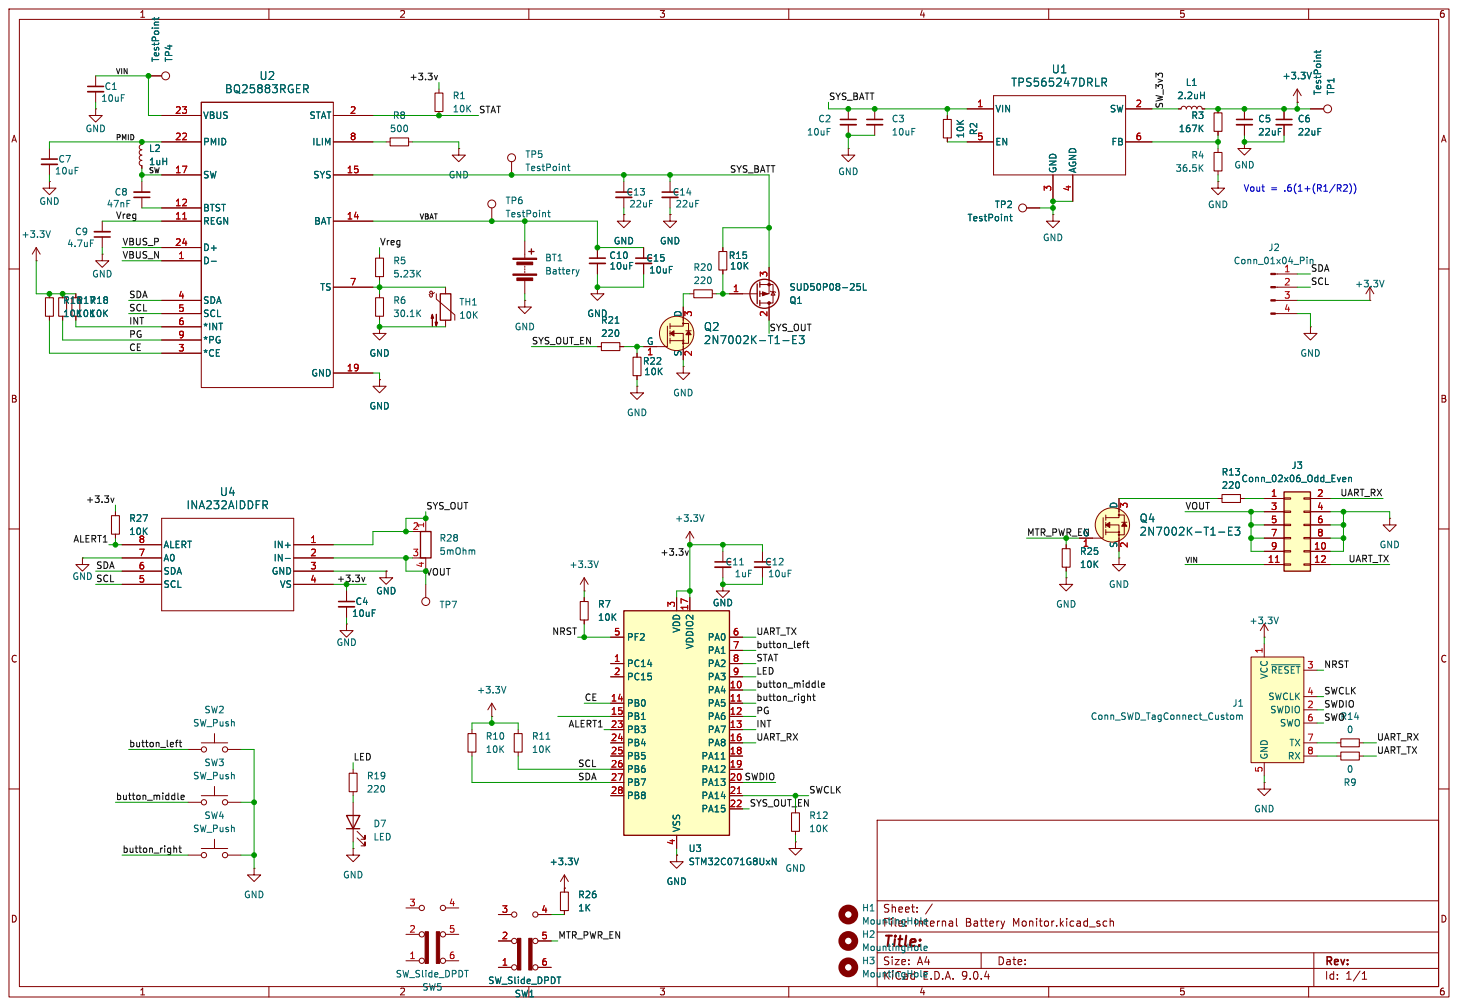
[picture p42: page 1]

5 ~{RESET}3 SWCLK 4 SWDIO 2 SWO 6 TX 7 RX 8
