ZSP-Electronics/ZSPR_01_Robot/firmware/STM32/Battery_Monitor_C071G/Core/Src/main.cpp

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
/* Includes ------------------------------------------------------------------*/
#include "main.h"
#include "dma.h"
#include "i2c.h"
#include "usart.h"
#include "gpio.h"


/* USER CODE BEGIN Includes */
#include "Hardware_config.h"
#include "stm32fxxx.h"
#include "ssd1306.h"
#include <BQ25883.h>
#include "DialogBold10.h"
#include "Battery_Link.h"
/* USER CODE END Includes */

/* USER CODE BEGIN PTD */
// I2C_HandleTypeDef hi2c1;
void update_button_states(void);
void readBatteryStatus(void);
bool estimateSystemLoadCurrent(float* currentAmps);
static void formatFloat2(float value, char* buf, size_t bufSize);
void serviceWatchdog(void);
void checkChargeFaults(void);
void checkInputCurrentFaults(void);
void readStatFields(void);
void drawPrimaryScreen(void);

#ifdef DEBUG
void printFirstFiveRegs(void);
void printAllFields(void);
void printBatteryStatus(void);
#endif
/* USER CODE END PTD */

/* USER CODE BEGIN PD */
// HardwareSerial Serial(&huart1);
BQ25883 charger = BQ25883();
STM32_SSD1306 display;
Battery_Link batteryLink;

/* USER CODE END PD */


/* USER CODE BEGIN PV */
bool battery_int_state = false;
bool left_button_state, middle_button_state, right_button_state = false;
bool previous_left_button_state, previous_middle_button_state, previous_right_button_state = false;
bool battery_pwr_good_state = false;
// uint8_t rxData[UART_BUFFER_SIZE];

//global variables for first five regsiters
float cellVoltageLimit = 0.0;

float chargeCurrentLimit = 0.0;
bool hizMode = true;
bool iLimPin  = false;

float inputVoltageLimit = 0.0;
bool vInDpmRst = false;
bool batDischg = true;
bool pfmOoa = true;

float inputCurrentLimit = 0.0;
bool forceIco = true;
bool forceIndet = true;
bool enIco = false;

float prechargeCurrentLimit = 0.0;
float terminationCurrentLimit = 0.0;

float batteryVoltage = 0.0;
float batteryCurrent = 0.0;
float ext1Voltage = 0.0;
float ext2Voltage = 0.0;
float ext1Current = 0.0;
float ext2Current = 0.0;
uint32_t lastBatteryReadTick = 0;

bool chargeFaultActive = false;
bool inputCurrentIssueActive = false;
bool displayExtPower = true;
/* USER CODE END PV */

/* USER CODE BEGIN PM */
#ifdef __cplusplus
extern "C" {
#endif

// int _write(int file, char *ptr, int len)
// {
//   HAL_UART_Transmit(&huart1, (uint8_t*)ptr, len, HAL_MAX_DELAY);
//   // HAL_UART_Transmit_IT(&huart1, (uint8_t*)ptr, len);
//   return len;
// }

// void HAL_GPIO_EXTI_Callback(uint16_t GPIO_Pin)
// {
// 	if(GPIO_Pin == battery_int_pin)
// 	{
// 		battery_int_state = HAL_GPIO_ReadPin(battery_int);
// 	}
// }

#ifdef __cplusplus
}
#endif
/* USER CODE END PM */



void SystemClock_Config(void);
/* USER CODE BEGIN 0 */

// uint8_T TxData[50];
/* USER CODE END 0 */

/**
  * @brief  The application entry point.
  * @retval int
  */
int main(void)
{

  /* MCU Configuration--------------------------------------------------------*/

  /* Reset of all peripherals, Initializes the Flash interface and the Systick. */
  HAL_Init();

  /* Configure the system clock */
  SystemClock_Config();

  /* USER CODE BEGIN SysInit */
  HAL_Delay(100);
  /* USER CODE END SysInit */

  /* Initialize all configured peripherals */
  MX_GPIO_Init();
  MX_DMA_Init();
  MX_I2C1_Init();
  MX_USART1_UART_Init();
  // /* USER CODE BEGIN 2 */
  Board_GPIO_WritePin(battery_cEnable, LOW);
  Serial.begin(BOARD_USART1);
  #ifdef DEBUG
  Serial.println("Hello World!");
  #endif

  display.SSD1306_begin(BOARD_I2C1, SSD1306_I2C_ADDR);
  display.SSD1306_setFont(&Dialog_bold_10);
  display.SSD1306_setFontSize(1);

  if(charger.begin(BOARD_I2C1)){
    #ifdef DEBUG
    Serial.println(F("BQ25883 is working..."));
    #endif
    charger.setADC_EN(true);        //enable ADC
    charger.setADC_ONE_SHOT(false); //continuous conversion mode so VBAT/ICHG stay up to date
    // ILIM is grounded directly (no resistor) on this board, which the IC reads as the
    // minimum input current tier; since the effective limit is min(ILIM pin, IINDPM
    // register), that floor silently overrides IINDPM. Disable the pin function so the
    // register is authoritative - see setInputCurrentLimit() for the actual limit.
    charger.setEN_CHG(true);
    charger.setHIZMode(false);          //HIZ already defaults off at power-on-reset, set explicitly so the input path isn't left implicit
    charger.setILIMPinFunction(false);
    charger.setInputCurrentLimit(0.5);  //set IINDPM to 0.5A, which is the actual limit on this board
    // ICHG otherwise sits at its 1.5A power-on default (never set elsewhere), which is
    // higher than IINDPM and therefore misleading to read back - align it to the same
    // 500mA ceiling so getChargeCurrentLimit() reflects what can actually flow.
    charger.setChargeCurrentLimit(0.5);
    // charger.setADC_SAMPLE_SPEED(0b00); //fastest conversion speed
    // charger.readChargeCurrentLimitReg(); //cache ICHG so getChargeCurrentLimit()
    charger.readCellVoltageLimitReg(); //cache VREG so getCellVoltageLimit() reflects the actual charger setting, not a zeroed default
  }
  else{
    // If BQ25883 is not working, blink the LED to indicate an error
    #ifdef DEBUG
    Serial.println(F("BQ25883 is NOT working.  Check your wires..."));
    #endif
    while(1){
      Board_GPIO_TogglePin(user_led);
      HAL_Delay(500);
    }
  }

  drawPrimaryScreen();

  // getFirstFiveRegs();
  // printFirstFiveRegs();

  // printAllFields();

  
  
  /* USER CODE END 2 */
  
  /* Infinite loop */
  /* USER CODE BEGIN WHILE */
  while (1)
  {

    // Service the Primary Controller link: answer REQUEST_VOLTAGE frames and
    // latch any SEND_CURRENT_POWER rail data pushed from the Primary.
    batteryLink.poll();

    if(batteryLink.has_current_power()){
      const Battery_Link::RailReadings &r = batteryLink.rails();
      ext1Voltage = r.sysBus_mV   / 1000.0f;
      ext1Current = r.sysCurrent_mA / 1000.0f;
      ext2Voltage = r.motorBus_mV / 1000.0f;
      ext2Current = r.motorCurrent_mA / 1000.0f;
    }

    update_button_states();

    if(HAL_GetTick() - lastBatteryReadTick >= 1000){
      lastBatteryReadTick = HAL_GetTick();
      HAL_GPIO_TogglePin(user_led);
      serviceWatchdog();
      checkChargeFaults();
      checkInputCurrentFaults();
      readBatteryStatus();
      // printBatteryStatus();
      drawPrimaryScreen();
    }

    /* USER CODE END WHILE */
    // Serial.println("Hello World!");
    // printf("Hello World!\r\n");
    // HAL_UART_Receive(&huart1, rxData, 5, HAL_MAX_DELAY);
    // HAL_GPIO_TogglePin(user_led);
    // HAL_Delay(100);
    /* USER CODE BEGIN 3 */
  }
  /* USER CODE END 3 */
}

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
