ZSP-Electronics/ZSPR_01_Robot/firmware/PlatformIO/ZSPR_01_Primary_Controller/src/peripheral_config.h

#pragma once

// Compile-time enable/disable for each peripheral subsystem. Set to 0 to
// fully compile a peripheral out (its driver, CLI commands, and protocol
// command handlers all disappear).

#define DEBUG

#define ENABLE_SERVO          1
#define ENABLE_TOF            1
#define ENABLE_CURRENT_SENSE  1
#define ENABLE_TOUCH          0 // capacitive touch: deactivated for now, kept buildable
#define ENABLE_IMU_COMPASS    1
#define ENABLE_SD             1
#define ENABLE_DISPLAY        0 // RGB parallel panel: frame buffer needs PSRAM (RGBPanel.h #errors without it); disable on non-PSRAM S3 modules
#define ENABLE_BUZZER         1
#define ENABLE_BATTERY        1 // Serial2 link to the battery controller board: protocol defined, not yet validated against real hardware

// Build-time application mode -- selects which loop() body runs (see
// main.cpp). Exactly one of these must be set to 1.
//   TEST:  periodic serial self-check of every enabled peripheral.
//   DEBUG: placeholder, not yet implemented.
//   PROD:  placeholder, not yet implemented.
#define TEST                    1
#define DEV                     0
#define PROD                    0

#if (TEST + DEV + PROD) != 1
#error "Exactly one of TEST, DEV, PROD must be set to 1 in peripheral_config.h"
#endif
