ZSP-Electronics/ZSPR_01_Robot/firmware/STM32/Battery_Monitor_C071G/Core/Src/gpio.c

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

/* Includes ------------------------------------------------------------------*/
#include "gpio.h"

/*----------------------------------------------------------------------------*/
/* Configure GPIO                                                             */
/*----------------------------------------------------------------------------*/
/* USER CODE BEGIN 1 */
#ifndef GPIO_USE_HAL
static void MX_GPIO_Init_LL(void)
{
  LL_GPIO_InitTypeDef GPIO_InitStruct = {0};

  LL_IOP_GRP1_EnableClock(LL_IOP_GRP1_PERIPH_GPIOC);
  LL_IOP_GRP1_EnableClock(LL_IOP_GRP1_PERIPH_GPIOF);
  LL_IOP_GRP1_EnableClock(LL_IOP_GRP1_PERIPH_GPIOA);
  LL_IOP_GRP1_EnableClock(LL_IOP_GRP1_PERIPH_GPIOB);

  LL_GPIO_ResetOutputPin(GPIOA, GPIO_PIN_3 | GPIO_PIN_6);
  LL_GPIO_ResetOutputPin(LED_GPIO_Port, LED_Pin);

  /* PC14 PC15 : Analog */
  GPIO_InitStruct.Pin = GPIO_PIN_14 | GPIO_PIN_15;
  GPIO_InitStruct.Mode = LL_GPIO_MODE_ANALOG;
  GPIO_InitStruct.Pull = LL_GPIO_PULL_NO;
  LL_GPIO_Init(GPIOC, &GPIO_InitStruct);

  /* PF2 : Analog */
  GPIO_InitStruct.Pin = GPIO_PIN_2;
  GPIO_InitStruct.Mode = LL_GPIO_MODE_ANALOG;
  GPIO_InitStruct.Pull = LL_GPIO_PULL_NO;
  LL_GPIO_Init(GPIOF, &GPIO_InitStruct);

  /* PA1 PA4 PA5 PA7 : Input, pull-up */
  GPIO_InitStruct.Pin = GPIO_PIN_1 | GPIO_PIN_4 | GPIO_PIN_5 | GPIO_PIN_7;
  GPIO_InitStruct.Mode = LL_GPIO_MODE_INPUT;
  GPIO_InitStruct.Pull = LL_GPIO_PULL_UP;
  LL_GPIO_Init(GPIOA, &GPIO_InitStruct);

  /* PA2 : Input, no pull */
  GPIO_InitStruct.Pin = GPIO_PIN_2 | GPIO_PIN_3;
  GPIO_InitStruct.Mode = LL_GPIO_MODE_INPUT;
  GPIO_InitStruct.Pull = LL_GPIO_PULL_NO;
  LL_GPIO_Init(GPIOA, &GPIO_InitStruct);

  /* PA3 PA6 : Output push-pull */
  GPIO_InitStruct.Pin = GPIO_PIN_6;
  GPIO_InitStruct.Mode = LL_GPIO_MODE_OUTPUT;
  GPIO_InitStruct.Pull = LL_GPIO_PULL_NO;
  GPIO_InitStruct.Speed = LL_GPIO_SPEED_FREQ_LOW;
  GPIO_InitStruct.OutputType = LL_GPIO_OUTPUT_PUSHPULL;
  LL_GPIO_Init(GPIOA, &GPIO_InitStruct);

  /* LED_Pin : Output push-pull */
  GPIO_InitStruct.Pin = LED_Pin;
  GPIO_InitStruct.Mode = LL_GPIO_MODE_OUTPUT;
  GPIO_InitStruct.Pull = LL_GPIO_PULL_NO;
  GPIO_InitStruct.Speed = LL_GPIO_SPEED_FREQ_LOW;
  GPIO_InitStruct.OutputType = LL_GPIO_OUTPUT_PUSHPULL;
  LL_GPIO_Init(LED_GPIO_Port, &GPIO_InitStruct);

  /* PB1 : Input, no pull */
  GPIO_InitStruct.Pin = GPIO_PIN_1;
  GPIO_InitStruct.Mode = LL_GPIO_MODE_INPUT;
  GPIO_InitStruct.Pull = LL_GPIO_PULL_NO;
  LL_GPIO_Init(GPIOB, &GPIO_InitStruct);

  /* PA11 PA12 PA15 : Analog */
  GPIO_InitStruct.Pin = GPIO_PIN_11 | GPIO_PIN_12 | GPIO_PIN_15;
  GPIO_InitStruct.Mode = LL_GPIO_MODE_ANALOG;
  GPIO_InitStruct.Pull = LL_GPIO_PULL_NO;
  LL_GPIO_Init(GPIOA, &GPIO_InitStruct);

  /* PB3 PB4 PB5 PB8 : Analog */
  GPIO_InitStruct.Pin = GPIO_PIN_3 | GPIO_PIN_4 | GPIO_PIN_5 | GPIO_PIN_8;
  GPIO_InitStruct.Mode = LL_GPIO_MODE_ANALOG;
  GPIO_InitStruct.Pull = LL_GPIO_PULL_NO;
  LL_GPIO_Init(GPIOB, &GPIO_InitStruct);
}

void Board_GPIO_WritePin(GPIO_TypeDef *port, uint16_t pin, GPIO_PinState state)
{
  if(state != GPIO_PIN_RESET)
    LL_GPIO_SetOutputPin(port, pin);
  else
    LL_GPIO_ResetOutputPin(port, pin);
}

void Board_GPIO_TogglePin(GPIO_TypeDef *port, uint16_t pin)
{
  LL_GPIO_TogglePin(port, pin);
}

GPIO_PinState Board_GPIO_ReadPin(GPIO_TypeDef *port, uint16_t pin)
{
  return LL_GPIO_IsInputPinSet(port, pin) ? GPIO_PIN_SET : GPIO_PIN_RESET;
}
#else
void Board_GPIO_WritePin(GPIO_TypeDef *port, uint16_t pin, GPIO_PinState state)
{
  HAL_GPIO_WritePin(port, pin, state);
}

void Board_GPIO_TogglePin(GPIO_TypeDef *port, uint16_t pin)
{
  HAL_GPIO_TogglePin(port, pin);
}

GPIO_PinState Board_GPIO_ReadPin(GPIO_TypeDef *port, uint16_t pin)
{
  return HAL_GPIO_ReadPin(port, pin);
}
#endif
/* USER CODE END 1 */

void MX_GPIO_Init(void)
{

  /* USER CODE BEGIN GPIO_Init 0 */
#ifndef GPIO_USE_HAL
  MX_GPIO_Init_LL();
  return;
#endif
  /* USER CODE END GPIO_Init 0 */

  GPIO_InitTypeDef GPIO_InitStruct = {0};

  /* GPIO Ports Clock Enable */
  __HAL_RCC_GPIOC_CLK_ENABLE();
  __HAL_RCC_GPIOF_CLK_ENABLE();
  __HAL_RCC_GPIOA_CLK_ENABLE();
  __HAL_RCC_GPIOB_CLK_ENABLE();

  /*Configure GPIO pin Output Level */
  HAL_GPIO_WritePin(GPIOA, GPIO_PIN_3|GPIO_PIN_6, GPIO_PIN_RESET);

  /*Configure GPIO pin Output Level */
  HAL_GPIO_WritePin(LED_GPIO_Port, LED_Pin, GPIO_PIN_RESET);

  /*Configure GPIO pins : PC14 PC15 */
  GPIO_InitStruct.Pin = GPIO_PIN_14|GPIO_PIN_15;
  GPIO_InitStruct.Mode = GPIO_MODE_ANALOG;
  GPIO_InitStruct.Pull = GPIO_NOPULL;
  HAL_GPIO_Init(GPIOC, &GPIO_InitStruct);

  /*Configure GPIO pin : PF2 */
  GPIO_InitStruct.Pin = GPIO_PIN_2;
  GPIO_InitStruct.Mode = GPIO_MODE_ANALOG;
  GPIO_InitStruct.Pull = GPIO_NOPULL;
  HAL_GPIO_Init(GPIOF, &GPIO_InitStruct);

  /*Configure GPIO pins : PA1 PA4 PA5 PA7 */
  GPIO_InitStruct.Pin = GPIO_PIN_1|GPIO_PIN_4|GPIO_PIN_5|GPIO_PIN_7;
  // GPIO_InitStruct.Mode = GPIO_MODE_IT_RISING;
  GPIO_InitStruct.Mode = GPIO_MODE_INPUT;
  GPIO_InitStruct.Pull = GPIO_PULLUP;
  HAL_GPIO_Init(GPIOA, &GPIO_InitStruct);

  /*Configure GPIO pin : PA2 */
  GPIO_InitStruct.Pin = GPIO_PIN_2;
  GPIO_InitStruct.Mode = GPIO_MODE_INPUT;
  GPIO_InitStruct.Pull = GPIO_NOPULL;
  HAL_GPIO_Init(GPIOA, &GPIO_InitStruct);

  /*Configure GPIO pins : PA3 PA6 */
  GPIO_InitStruct.Pin = GPIO_PIN_3|GPIO_PIN_6;
  GPIO_InitStruct.Mode = GPIO_MODE_OUTPUT_PP;
  GPIO_InitStruct.Pull = GPIO_NOPULL;
  GPIO_InitStruct.Speed = GPIO_SPEED_FREQ_LOW;
  HAL_GPIO_Init(GPIOA, &GPIO_InitStruct);

  /*Configure GPIO pin : LED_Pin */
  GPIO_InitStruct.Pin = LED_Pin;
  GPIO_InitStruct.Mode = GPIO_MODE_OUTPUT_PP;
  GPIO_InitStruct.Pull = GPIO_NOPULL;
  GPIO_InitStruct.Speed = GPIO_SPEED_FREQ_LOW;
  HAL_GPIO_Init(LED_GPIO_Port, &GPIO_InitStruct);

  /*Configure GPIO pin : PB1 */
  GPIO_InitStruct.Pin = GPIO_PIN_1;
  GPIO_InitStruct.Mode = GPIO_MODE_INPUT;
  GPIO_InitStruct.Pull = GPIO_NOPULL;
  HAL_GPIO_Init(GPIOB, &GPIO_InitStruct);

  /*Configure GPIO pins : PA11 PA12 PA15 */
  GPIO_InitStruct.Pin = GPIO_PIN_11|GPIO_PIN_12|GPIO_PIN_15;
  GPIO_InitStruct.Mode = GPIO_MODE_ANALOG;
  GPIO_InitStruct.Pull = GPIO_NOPULL;
  HAL_GPIO_Init(GPIOA, &GPIO_InitStruct);

  /*Configure GPIO pins : PB3 PB4 PB5 PB8 */
  GPIO_InitStruct.Pin = GPIO_PIN_3|GPIO_PIN_4|GPIO_PIN_5|GPIO_PIN_8;
  GPIO_InitStruct.Mode = GPIO_MODE_ANALOG;
  GPIO_InitStruct.Pull = GPIO_NOPULL;
  HAL_GPIO_Init(GPIOB, &GPIO_InitStruct);

  /* EXTI interrupt init*/
  // HAL_NVIC_SetPriority(EXTI0_1_IRQn, 0, 0);
  // HAL_NVIC_EnableIRQ(EXTI0_1_IRQn);

  // HAL_NVIC_SetPriority(EXTI4_15_IRQn, 0, 0);
  // HAL_NVIC_EnableIRQ(EXTI4_15_IRQn);

}
