ZSP-Electronics/ZSPR_01_Robot/(commit log)

2026-08-13 Initial Staging
    [bom.csv, designators.csv, positions.csv]
2026-08-23 Added rendered gif of board
2026-08-25 Added schematic and 3d step file
    [Primary Robot Controller.step]
2026-09-16 STL Included
    [ZSPR_01_Print_Layout.3mf, arm_arm_body1_mirror.stl, arm_arm_body2_mirror.stl, arm_house_back.stl, arm_house_front1.stl, arm_house_front2.stl, arm_housing_tensioner_mirror.stl, arm_link1_2x.stl]
2026-09-27 Updated hardware for Primary Controller v1.4 and Battery Monitor V1.0
    [Internal Battery Monitor.step, Primary Robot Controller.step, bom.csv, designators.csv, positions.csv]
2026-09-27 Added Charge Board and servo bus
    [Charge Board.step, Servo_Bus.step, bom.csv, designators.csv, positions.csv]
