ZSP-Electronics/ZSPR_01_Robot/(notices)

Notices in the files:
firmware/STM32/Battery_Monitor_C071G/Core/Src/main.cpp:
Copyright (c) 2026 STMicroelectronics.
All rights reserved.
This software is licensed under terms that can be found in the LICENSE file
